agusoa2008-sudo/lsf-ecoypf-performance/motor y driver/driver.jpeg

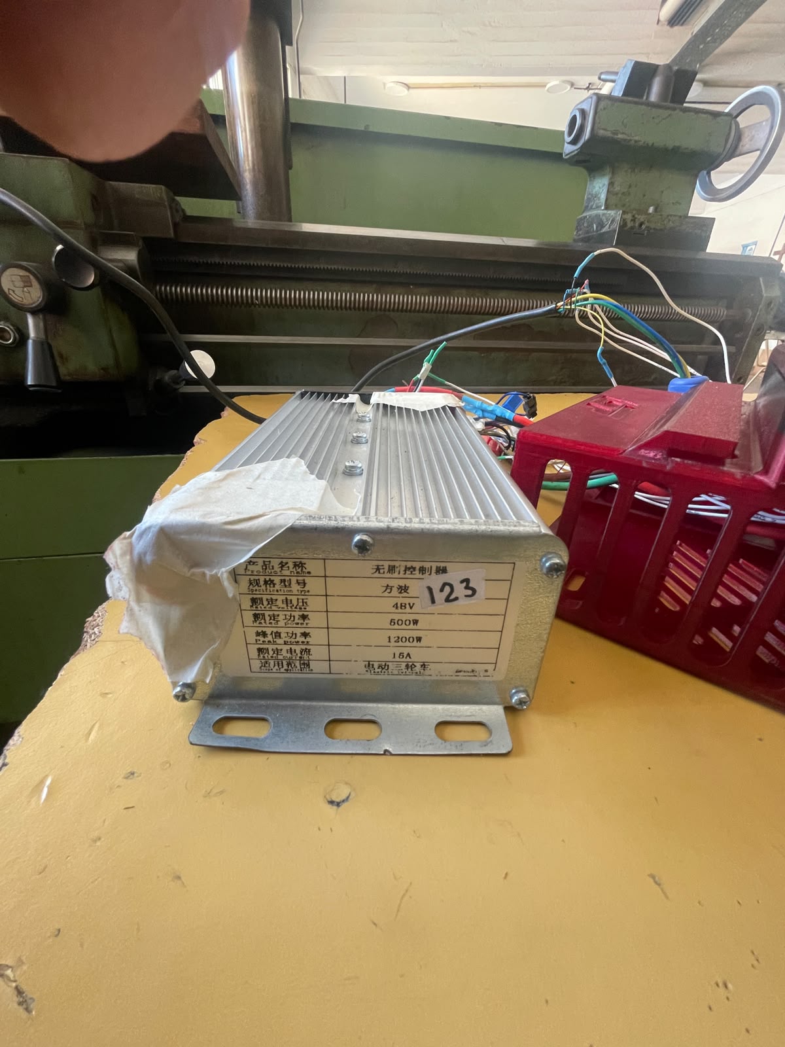
motor y driver/driver.jpeg
