agusoa2008-sudo/lsf-ecoypf-performance/motor y driver/motor.jpeg

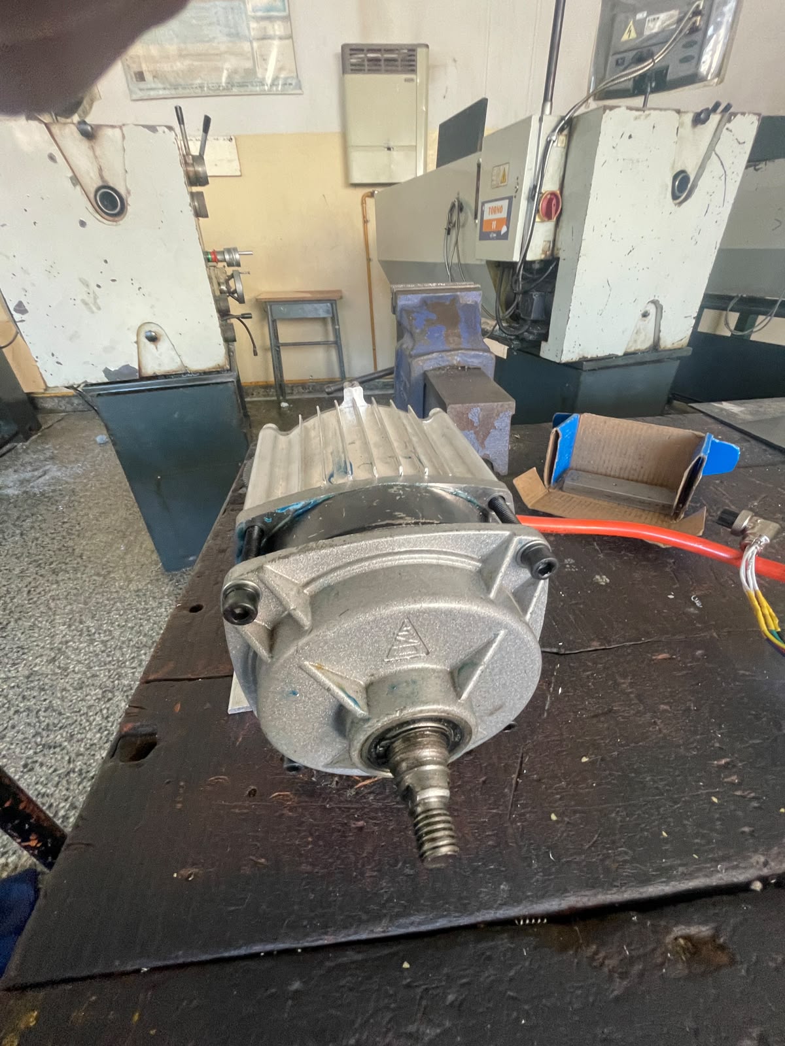
motor y driver/motor.jpeg
