agusoa2008-sudo/lsf-ecoypf-performance/Heltec T190/t190.pdf

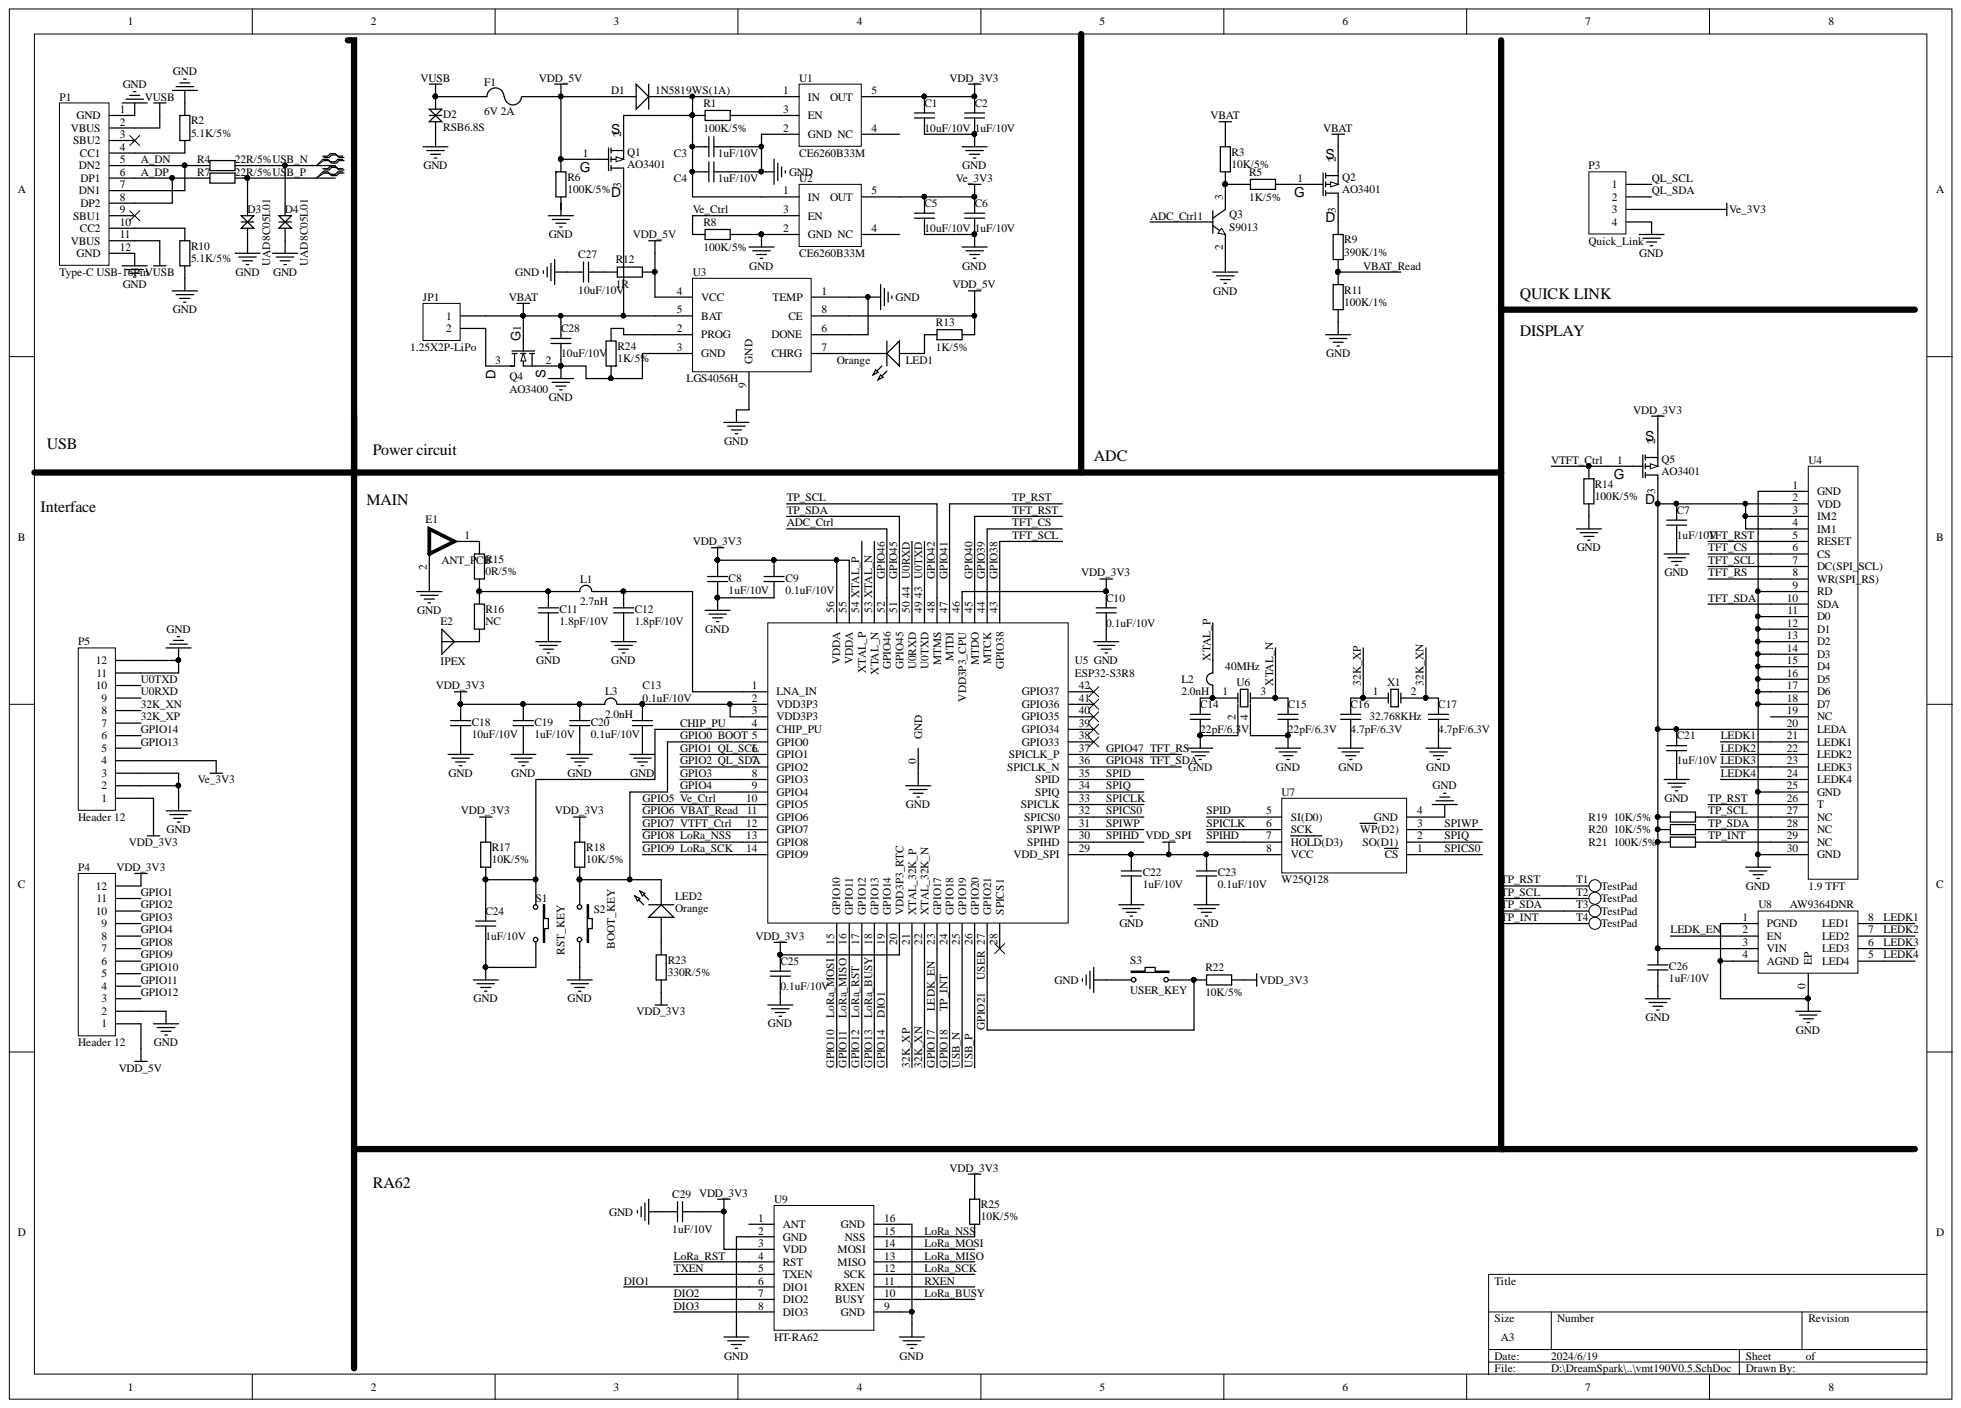
[picture p6: page 1]

GPIO38 43 MTCK 44 MTDO 45 VDD3P3_CPU 46 MTDI 47 MTMS 48 U0TXD 49 U0RXD 50 GPIO45 51 GPIO46 52 XTAL_N 53 XTAL_P 54 VDDA 55 VDDA 56 GND 0

3 | 12 MISO 13 MOSI 14 NSS 15 GND 16 1 SCK
