agusoa2008-sudo/lsf-ecoypf-performance/Heltec T190/sh2.0_interface_4F32C39EE011CAA34840C9E4E87704C4.pdf

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

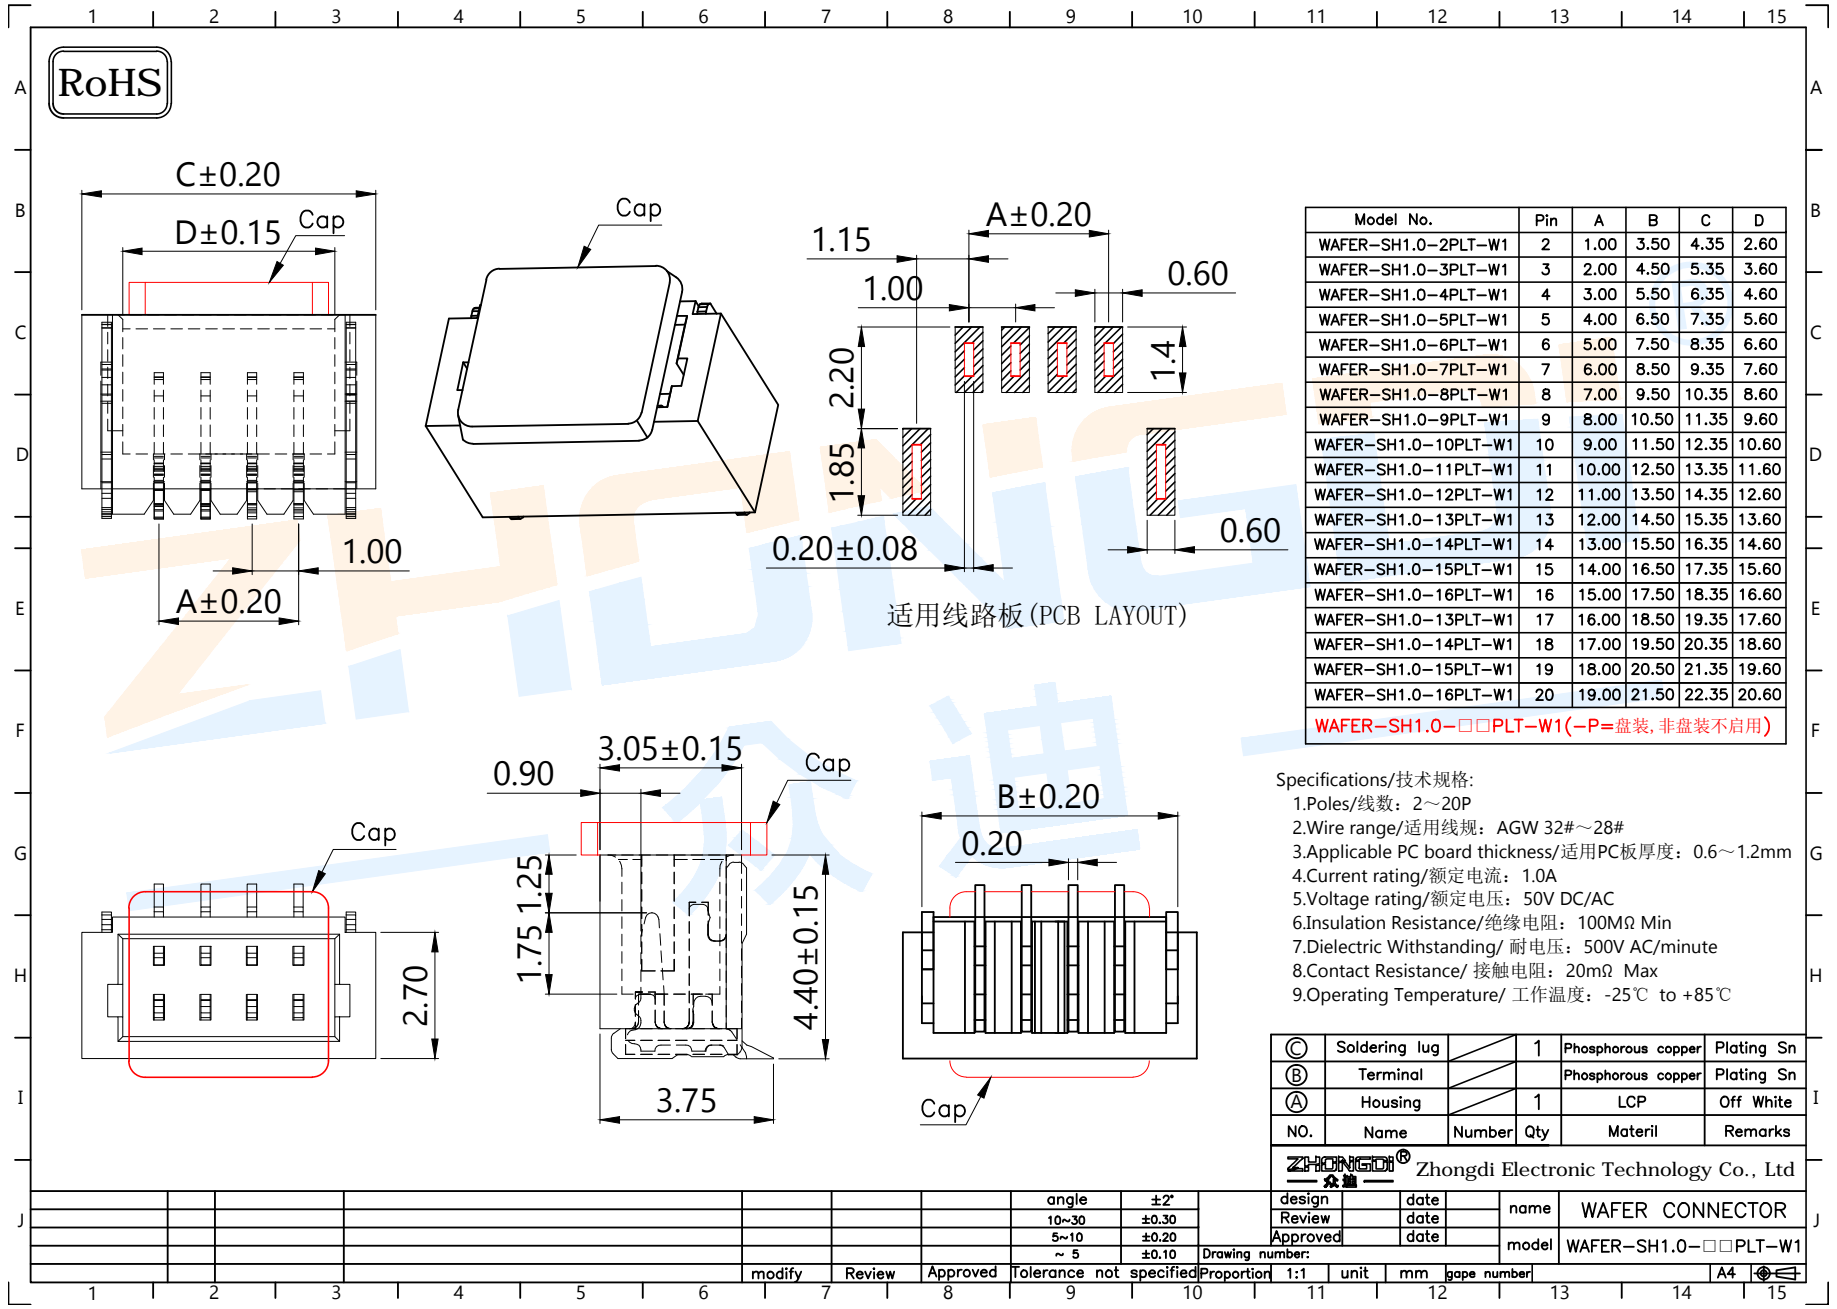
[picture p7: page 1]
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
