agusoa2008-sudo/lsf-ecoypf-performance/diagnostico espnow/t190-device/main.py

# main.py — Heltec T190 v3: display remoto del Super Mini (eBike2026)
#
# El T190 no lee los sensores de traccion/corriente/velocidad -- todo eso
# vive en el Super Mini (ver ../SUPER MINI S3/), que hace las lecturas y los
# calculos (Wh, potencia, eficiencia) y los manda por ESP-NOW. El T190
# solo recibe, muestra en pantalla, y reenvia por LoRa (SX1262) a una base
# remota. Tambien mide su bateria interna para mostrar el estado del T190.
# Ver espnow_link.py para el protocolo de pairing (T190 = quien
# acepta, Super Mini = iniciador -- INVERTIDO respecto a la version vieja
# de este archivo, que leia sensores locales y/o mandaba a un segundo
# display tipo Ideaspark).
#
# El Super Mini envia telemetria por ESP-NOW; el T190 la muestra y retransmite
# por LoRa. El GPS y la bateria local del T190 se supervisan en tareas propias.
#
# - Display: un valor a la vez, fuente 7 segmentos blanco sobre negro.
#   Fila de arriba: estado del link ESP-NOW (antes tenia hints de
#   navegacion prev/next, se saco para dejar lugar al estado).
#
# - Pantallas: PAGES (definida cerca del final del archivo) reemplaza la
#   vieja lista plana FIELDS -- cada pagina es un descriptor con su propia
#   funcion de dibujo. Pagina 0 = CARRERA (home, potencia objetivo vs.
#   actual). BTN0 corto ya no es contextual por pagina (ver mas abajo).
#
# - Dos botones (ver HW.py y ARQUITECTURA_TELEMETRIA_ECOYPF.md §5). Short
#   dispara siempre al instante al soltar; double es un evento ADICIONAL
#   (no exclusivo) que se suma si el segundo tap llega dentro de DOUBLE_MS
#   -- ver buttons.py. Combo: si se suelta un boton en modo "short" MIENTRAS
#   el otro esta sostenido, dispara el gesto "combo" de ese boton en vez de
#   short/double (ver buttons.py: PageButton._handle_release).
#     BTN0  (GPIO0)  corto          -> pantalla siguiente (bloqueado si hay
#                                     un modo especial activo, ver abajo)
#     BTN0  (GPIO0)  doble          -> ver ENERGIA restante 5s y volver solo
#                                     a la pantalla activa (_on_btn0_double_
#                                     peek_energia)
#     BTN0  (GPIO0)  largo          -> escape universal: siempre va a
#                                     CARRERA y sale de cualquier modo
#                                     especial activo (_on_home)
#     BTN0  (GPIO0)  extra (>=2.2s) -> activa el modo especial de la
#                                     pantalla actual (_on_btn0_extra)
#     BTN0 sostenido + S3 corto     -> reset remoto del Super Mini (combo,
#                                     con doble confirmacion -- ver Fase 5)
#     S3    (GPIO21) corto          -> pantalla anterior (mismo bloqueo)
#     S3    (GPIO21) doble          -> largada: captura waypoint GPS +
#                                     arranca el reloj de carrera (si no
#                                     estaba corriendo) + va al cartel de
#                                     CARRERA, sin entrar directo al modo
#                                     en vivo (_on_s3_double_start)
#     S3    (GPIO21) largo          -> ir a CONFIGURACION (solo navega;
#                                     no abre el AP, ver mas abajo)
#     S3    (GPIO21) extra (>=2.2s) -> deep sleep al soltar
#     S3 sostenido + BTN0 corto     -> alternar log SD (combo)
#
#   Modos especiales -- CARRERA, SPRINT, CONFIG, CARGA, REINICIO y
#   WAYPOINT son pantallas "cartel": en navegacion normal muestran solo
#   un aviso de entrada, nunca los datos en vivo. SIEMPRE hay que estar
#   parado en la pantalla correcta y sostener BTN0 extra (~2.2s) para
#   activar el modo -- no hay atajo que se salte este paso, ni siquiera
#   S3 doble. Mismo gesto para salir, excepto REINICIO y WAYPOINT, que
#   ejecutan al toque (no son un modo que se "entre"):
#     CARRERA  -> potencia actual vs. objetivo; arranca el reloj de 80 min
#     SPRINT   -> velocidad + cronometro propio de la tanda
#     CONFIG   -> abre/cierra el AP de configuracion (_on_config_ap_toggle)
#     CARGA    -> monitorea Wh+ mientras carga; al salir registra lo
#                 acumulado como la nueva capacidad del pack
#     REINICIO -> pone en cero viaje/reloj de carrera/Peukert sin tocar la
#                 capacidad registrada (_on_reinicio_execute)
#     WAYPOINT -> (re)captura el punto de largada/llegada GPS sin arrancar
#                 la carrera ni navegar a otro lado (_on_waypoint_execute)
#
#   _on_race_toggle (pausar/reanudar la carrera a mitad de tanda) quedo sin
#   gesto asignado -- a definir si hace falta (ver su docstring).
#
# Patron "REPL libre": toda la app corre en un _thread aparte (igual que
# uPy reference Martin/FC Upy/eBike Old/inDev/t.py). Al bootear, main.py
# arranca el hilo y retorna enseguida -- la consola queda disponible para
# llamar status() / stop() / start() / next_field() / prev_field() /
# reset_trip() / espnow_status() / espnow_repair() directo (sin
# `import main` -- ver nota en conversacion sobre por que).

import _thread
import sys
import math
import time
import machine
import esp32
import uasyncio as asyncio
from machine import Pin, SPI

import HW
from drivers.tft170 import TFT170, rgb565
from buttons import InterruptPageButton
from telemetry import TelemetryRuntime
from espnow_link import EspNowLink, mac_str
from battery import percent_from_voltage
from gps import GPSReceiver
from sd_logger import TripLogger
from settings import T190Settings, RACE_DURATION_S
from config_server import ConfigServer, AP_SSID, AP_IP
import seven_seg
from fonts import seven_segment_80 as SEG80
from fonts import seven_segment_40 as SEG40

try:
    from sx1262 import SX1262
except ImportError:
    SX1262 = None

BLACK = 0x0000
WHITE = 0xFFFF
GRAY = rgb565(220, 220, 220)
RED = rgb565(220, 40, 40)
GREEN = rgb565(40, 200, 40)

# ── Pantallas: ver PAGES, definida cerca del final de este archivo (luego
# de las funciones _draw_* y de los handlers de boton que referencia, ya
# que la lista se construye en orden de ejecucion del modulo). Reemplaza a
# la vieja lista plana FIELDS + los offsets fijos len(FIELDS)+N.

# Umbrales de cruce de vuelta por GPS (ver _check_lap_crossing) -- 15m de
# tolerancia alrededor del waypoint capturado con S3 corto, con cooldown
# para no contar como varias vueltas un paso lento por la linea.
LAP_CROSS_THRESHOLD_M = 15.0
LAP_COOLDOWN_MS = 20000

# Reset remoto del Super Mini (combo BTN0 sostenido + S3 corto, ver Fase 5):
# doble confirmacion (primer combo arma, hay que repetirlo dentro de esta
# ventana) + timeout de espera del ACK del Super Mini.
REMOTE_RESET_CONFIRM_WINDOW_MS = 5000
RESET_ACK_TIMEOUT_MS = 4000

AUTO_START = True
IDLE_SLEEP_TIMEOUT_MS = 20 * 60 * 1000
IDLE_SPEED_THRESHOLD_KMH = 0.1
IDLE_SLEEP_CHECK_INTERVAL_MS = 1000
# Si el Super Mini se duerme (o queda fuera de rango) deja de mandar ESP-NOW
# y la telemetria pasa a STALE (ver telemetry.SOURCE_STALE_MS). Pasado este
# tiempo adicional sin que vuelva, el T190 lo acompaña a deep sleep -- ya
# estaba recibiendo datos antes, no es el caso de "todavia no emparejo".
SUPERMINI_LOST_SLEEP_TIMEOUT_MS = 30 * 1000
SD_LOG_SAMPLE_INTERVAL_MS = 1000
_RUNNING = False
_STOP_REQUESTED = False
_SLEEP_REQUESTED = False
_LOG_MANUAL_OVERRIDE = None
_BG_THREAD_STACK = 12288

_rt = None          # TelemetryRuntime
_en = None          # EspNowLink
_lora = None
_shared_spi = None
_sd_logger = None
_sd_error = None
_tft = None
_field_idx = 0
_dirty = True
_battery_voltage = None
_battery_percent = None
_battery_error = None
_battery_adc_raw = None
_battery_adc_pin_voltage = None
_battery_adc_read_method = None
_gps = None
_lap_waypoint = None       # (lat, lon) de largada/llegada -- S3 doble o WAYPOINT
_lap_count = 0
_last_lap_time_s = None
_lap_start_ms = None
_lap_last_cross_ms = 0
_gps_clock_synced = False
_gps_time_update_seen = 0
_gps_last_rtc_sync_ms = 0
_settings = None
_CONFIG_AP_REQUESTED = False
_CONFIG_AP_STOP_REQUESTED = False
_CONFIG_AP_RUNNING = False
_supermini_config_ack_revision = None
_supermini_config_error = None
_supermini_config_error_revision = None
_charge_wh_accum = 0.0
_charge_session_active = False
_CHARGE_THRESHOLD_A = 0.5   # |I| magnitude to detect charge / discharge
_last_button_activity_ms = 0
_sleep_warn_s = None        # segundos restantes del auto-sleep en curso, o None
_sleep_warn_reason = None   # "idle" (parado) o "lost" (Super Mini ausente)
_toast_text = None          # confirmacion momentanea (waypoint, reset), o None
_toast_started_ms = 0
TOAST_DURATION_MS = 4000

_peek_page_idx = None        # indice de PAGES mostrado temporalmente, o None
_peek_until_ms = 0
PEEK_DURATION_MS = 5000      # BTN0 doble: cuanto se muestra ENERGIA antes de volver

# CARRERA (Endurance): banda verde alrededor de potencia objetivo -- afuera
# (de mas o de menos), rojo. 10W es punto de partida; si en banco titila
# demasiado con el ruido normal de PA (EMA de 5s), subir este numero.
CARRERA_POWER_TOLERANCE_W = 10

# Modo especial (CARRERA/SPRINT/CARGA): mismo patron para los tres --
# cartel de entrada en navegacion normal (_draw_*_launcher), BTN0
# extra-largo (~2.2s) parado ahi activa los valores en vivo (_LIVE_DRAW,
# ver _draw_field) y bloquea BTN0/S3 corto (_in_locked_mode) para no
# salirse sin querer; el mismo gesto de nuevo sale (_on_toggle_mode_lock).
# CONFIG/AP sigue el mismo gesto (BTN0 extra, ver _on_btn0_extra) pero
# con su propio estado async ya existente (_CONFIG_AP_RUNNING/
# _CONFIG_AP_REQUESTED) en vez de _mode_locked -- por eso ambos entran en
# _in_locked_mode(). REINICIO usa el mismo gesto pero es de una sola vez,
# sin modo que mantener (ver _on_reinicio_execute).
#
# Entrar arranca el cronometro/acumulador que corresponda: en CARRERA, el
# reloj de carrera de 80 min (si no estaba corriendo ya); en SPRINT, un
# cronometro local propio (a Sprint no le importa la energia, solo el
# tiempo); en CARGA, el acumulador de Wh+ arranca de 0. Salir de CARGA
# registra lo acumulado como la nueva capacidad del pack.
_mode_locked = False
_sprint_start_ms = None   # None = cronometro de SPRINT detenido


def _in_locked_mode():
    """True si hay algun modo especial activo (bloquea next/prev, ver
    _on_next/_on_prev) -- CARRERA/SPRINT/CARGA via _mode_locked, o
    CONFIG/AP via su propio estado async."""
    return _mode_locked or _CONFIG_AP_RUNNING or _CONFIG_AP_REQUESTED


def _sprint_elapsed_s():
    if _sprint_start_ms is None:
        return 0.0
    return time.ticks_diff(time.ticks_ms(), _sprint_start_ms) / 1000.0


# Reset remoto del Super Mini (ver _on_remote_reset_request/Fase 5)
_reset_request_id = 0
_reset_ack_status = None    # None|"pending"|"ok"|"rejected"|"failed"|"timeout"
_reset_ack_deadline_ms = 0
_remote_reset_armed_until_ms = 0


# ── Hardware ─────────────────────────────────────────────────────────────────

def make_display():
    HW.display_power_on()
    time.sleep_ms(20)
    spi = SPI(
        HW.TFT_SPI_ID, baudrate=HW.TFT_BAUDRATE, polarity=0, phase=0,
        sck=machine.Pin(HW.TFT_SCK), mosi=machine.Pin(HW.TFT_MOSI), miso=None,
    )
    return TFT170(
        spi,
        dc=machine.Pin(HW.TFT_DC, machine.Pin.OUT),
        rst=machine.Pin(HW.TFT_RST, machine.Pin.OUT),
        cs=machine.Pin(HW.TFT_CS, machine.Pin.OUT),
        bl=machine.Pin(HW.TFT_BL, machine.Pin.OUT),
        rotation=1,   # landscape 320x170 -- mas ancho para la fuente de 80px
    )


def make_shared_spi():
    try:
        Pin(HW.LORA_CS, Pin.OUT, value=1)
        Pin(HW.SD_CS_PIN, Pin.OUT, value=1)
        return SPI(
            HW.SD_SPI_ID, baudrate=2_000_000, polarity=0, phase=0,
            sck=Pin(HW.SD_SCK_PIN), mosi=Pin(HW.SD_MOSI_PIN),
            miso=Pin(HW.SD_MISO_PIN),
        )
    except Exception as exc:
        print("[SPI] no se pudo crear el bus compartido LoRa/SD:", exc)
        return None


def make_lora(spi=None):
    if SX1262 is None:
        print("[LoRa] driver sx1262 no disponible")
        return None
    try:
        lora = SX1262(
            spi_bus=2,  # distinto del SPI(1) del display (ver loralcd_test.py)
            clk=HW.LORA_SCK, mosi=HW.LORA_MOSI, miso=HW.LORA_MISO,
            cs=HW.LORA_CS, irq=HW.LORA_DIO1,
            rst=HW.LORA_RST, gpio=HW.LORA_BUSY, spi=spi,
        )
        lora.begin(
            freq=HW.LORA_FREQ_MHZ,
            bw=HW.LORA_BW_KHZ,
            sf=HW.LORA_SF,
            cr=HW.LORA_CR,
            syncWord=HW.LORA_SYNC_WORD,
            power=HW.LORA_POWER_DBM,
            currentLimit=HW.LORA_CURRENT_LIMIT_MA,
            preambleLength=HW.LORA_PREAMBLE_LEN,
            tcxoVoltage=HW.LORA_TCXO_VOLTAGE,
        )
        if spi is not None and lora.spi is not spi:
            raise RuntimeError("SX1262 no conserva la instancia SPI compartida")
        print("[LoRa] OK @ {} MHz BW={} SF{} CR4/{} {} dBm".format(
            HW.LORA_FREQ_MHZ, HW.LORA_BW_KHZ, HW.LORA_SF,
            HW.LORA_CR, HW.LORA_POWER_DBM))
        return lora
    except Exception as exc:
        print("[LoRa] init error:", exc)
        return None


def make_sd_logger(spi):
    global _sd_error
    if spi is None:
        _sd_error = "bus SPI no disponible"
        print("[SD] logger inactivo: no hay bus SPI compartido")
        return None
    logger = None
    try:
        logger = TripLogger(
            spi, sd_cs_pin=HW.SD_CS_PIN, lora_cs_pin=HW.LORA_CS,
            spi_baudrate=2_000_000,
        )
        logger.mount()
        if logger.card.spi is not spi:
            raise RuntimeError("driver SD no conserva la instancia SPI compartida")
    except Exception as exc:
        _sd_error = "{}".format(exc)
        if logger is not None:
            logger.error = _sd_error
        print("[SD] inicializacion fallida:", exc)
        return logger
    _sd_error = None
    print("[SD] FAT montado: {} sectores ({:.2f} GiB)".format(
        logger.sectors, logger.sectors * 512 / (1024 * 1024 * 1024)))
    return logger


def make_espnow(on_telemetry, on_config_ack, on_reset_ack):
    try:
        link = EspNowLink(
            on_telemetry=on_telemetry, on_config_ack=on_config_ack,
            on_reset_ack=on_reset_ack)
        if link.paired:
            print("[espnow] OK, peer recordado:", mac_str(link.peer))
        else:
            print("[espnow] OK, esperando Super Mini...")
        return link
    except Exception as exc:
        print("[espnow] init error:", exc)
        return None


def make_gps():
    try:
        uart = machine.UART(
            HW.GPS_UART_ID, baudrate=HW.GPS_BAUDRATE,
            tx=HW.GPS_TX_PIN, rx=HW.GPS_RX_PIN, timeout=0,
        )
        print("[GPS] UART{} RX=GPIO{} TX=GPIO{} @ {} baud".format(
            HW.GPS_UART_ID, HW.GPS_RX_PIN, HW.GPS_TX_PIN, HW.GPS_BAUDRATE))
        return GPSReceiver(uart)
    except Exception as exc:
        print("[GPS] init error:", exc)
        return None


# ── UI ───────────────────────────────────────────────────────────────────────

def _espnow_link_text():
    """Texto + color del estado del link ESP-NOW con el Super Mini, para
    la fila 1 (reemplaza los hints de navegacion prev/next de antes)."""
    if _en is None:
        return "ESPNOW: no disponible", RED
    if not _en.paired:
        return "ESPNOW: esperando Super Mini...", GRAY
    if _en.fresh and _rt is not None and _rt.source_fresh():
        age_s = time.ticks_diff(time.ticks_ms(), _en.last_rx_ms) / 1000.0
        return "ESPNOW: OK ({:.1f}s)".format(age_s), GREEN
    return "ESPNOW: SIN DATOS (perdido)", RED


def _gps_status():
    if _gps is None:
        return "GPS:ERR", RED
    sats = _gps.satellites
    if _gps.has_fix():
        return "GPS:{}s".format(sats), GREEN
    return "GPS:{}--".format(sats), GRAY


def _sd_log_status():
    if _sd_logger is None:
        return ("SD:ERR", RED) if _sd_error else ("SD:--", GRAY)
    if _sd_logger.error is not None:
        return "SD:ERR", RED
    if _sd_logger.recording:
        return "SD:REC", GREEN
    if _sd_logger.ready:
        return "SD:ARM", GRAY
    return "SD:--", GRAY


def _sleep_warning_text():
    """Texto de aviso de auto-sleep inminente (ver idle_sleep_task), o
    None si no hay ningun temporizador de auto-sleep corriendo."""
    if _sleep_warn_s is None:
        return None
    detail = "Super Mini ausente" if _sleep_warn_reason == "lost" else "detenido"
    return "DUERME EN {}s ({})".format(_sleep_warn_s, detail)


def _show_toast(text):
    """Confirmacion momentanea en pantalla (waypoint capturado, reset de
    viaje, etc.) -- ui_task redibuja cada <=300ms sin necesidad de
    _dirty, asi que alcanza con guardar el texto y el instante inicial
    para que _toast_line() lo apague solo pasado TOAST_DURATION_MS."""
    global _toast_text, _toast_started_ms, _dirty
    _toast_text = text
    _toast_started_ms = time.ticks_ms()
    _dirty = True


def _toast_line():
    if _toast_text is None:
        return None
    if time.ticks_diff(time.ticks_ms(), _toast_started_ms) >= TOAST_DURATION_MS:
        return None
    return _toast_text


def _trip_whkm_avg():
    """Wh/km del periodo actual (desde el ultimo reset_trip), calculado
    aca con los deltas locales de settings.py -- no es el WA de vida
    entera que manda el Super Mini, que no se entera de resets."""
    if _settings is None:
        return 0.0
    km = _settings.trip_distance_m / 1000.0
    return (_settings.battery_used_wh / km) if km > 0.01 else 0.0


def _art_timestamp():
    if not _gps_clock_synced:
        return None
    tm = time.localtime()
    return "{:04d}-{:02d}-{:02d} {:02d}:{:02d}:{:02d}".format(
        tm[0], tm[1], tm[2], tm[3], tm[4], tm[5])


def _format_mmss(seconds):
    seconds = max(0, int(seconds))
    return "{:02d}:{:02d}".format(seconds // 60, seconds % 60)


def _power_target_w():
    """Potencia objetivo (W) = energia restante (Peukert) / tiempo restante
    de carrera -- ver docs/ARQUITECTURA_TELEMETRIA_ECOYPF.md §0. None si la
    carrera no esta corriendo o todavia no hay linea de base de energia."""
    if _settings is None or _settings.race_state != "running":
        return None
    remaining_s = _settings.race_remaining_s()
    if remaining_s <= 0:
        return None
    energy_wh = _settings.energy_remaining_peukert_wh
    if energy_wh is None:
        return None
    return energy_wh / (remaining_s / 3600.0)


def _approx_distance_m(lat1, lon1, lat2, lon2):
    """Distancia aproximada (equirectangular) -- de sobra para las
    distancias cortas de una linea de largada/llegada de pista."""
    lat_rad = math.radians((lat1 + lat2) / 2.0)
    dlat_m = (lat2 - lat1) * 111320.0
    dlon_m = (lon2 - lon1) * 111320.0 * math.cos(lat_rad)
    return math.sqrt(dlat_m * dlat_m + dlon_m * dlon_m)


def _check_lap_crossing():
    """Si hay un waypoint de largada/llegada capturado (S3 corto) y el fix
    GPS actual esta a menos de LAP_CROSS_THRESHOLD_M, cuenta una vuelta --
    con cooldown para no contar varias veces un paso lento por la linea."""
    global _lap_count, _last_lap_time_s, _lap_start_ms, _lap_last_cross_ms
    global _dirty
    if _lap_waypoint is None or _gps is None:
        return
    fix = _gps.latest_fix()
    if fix is None:
        return
    now = time.ticks_ms()
    if time.ticks_diff(now, _lap_last_cross_ms) < LAP_COOLDOWN_MS:
        return
    distance_m = _approx_distance_m(
        _lap_waypoint[0], _lap_waypoint[1], fix["latitude"], fix["longitude"])
    if distance_m > LAP_CROSS_THRESHOLD_M:
        return
    _lap_count += 1
    if _lap_start_ms is not None:
        _last_lap_time_s = time.ticks_diff(now, _lap_start_ms) / 1000.0
    _lap_start_ms = now
    _lap_last_cross_ms = now
    _show_toast("Vuelta {} -- {}".format(
        _lap_count, _format_mmss(_last_lap_time_s or 0)))
    _dirty = True


def _page_count():
    return len(PAGES)


def _page_label(idx):
    return PAGES[idx]["label"]


def _draw_diagnostics(tft, idx):
    tft.fill(BLACK)
    tft.text("DIAGNOSTICO  {}/{}".format(idx + 1, _page_count()), 8, 4, WHITE)
    tft.hline(0, 20, tft.width, rgb565(70, 80, 90))

    state = _rt.state if _rt is not None else None
    source_fresh = _rt is not None and _rt.source_fresh()
    if state is None or not source_fresh:
        ads_text, ads_color = "ADS: sin telemetria fresca", RED
    else:
        ads_text = "ADS V:{}  I:{}  RX:{}#{}".format(
            "OK" if state.adc_valid else "ERR",
            "OK" if state.current_valid else "ERR",
            state.espnow_rx_count, state.source_seq)
        ads_color = GREEN if state.adc_valid and state.current_valid else RED
    tft.text(ads_text[:39], 8, 30, ads_color)

    if _sd_logger is None:
        sd_detail = _sd_error or "no inicializada"
        sd_color = RED if _sd_error else GRAY
    elif _sd_logger.error:
        sd_detail = _sd_logger.error
        sd_color = RED
    elif _sd_logger.recording:
        sd_detail = "REC {}".format(_sd_logger.path)
        sd_color = GREEN
    elif _sd_logger.ready:
        sd_detail = "OK {:.1f} GiB".format(
            _sd_logger.sectors * 512 / (1024 * 1024 * 1024))
        sd_color = WHITE
    else:
        sd_detail = "no montada"
        sd_color = RED
    tft.text(("SD: " + sd_detail)[:39], 8, 48, sd_color)

    if _gps is None:
        gps_text, gps_color = "GPS: no inicializado", RED
    elif _gps.has_fix():
        gps_text = "GPS FIX sats:{}".format(_gps.satellites)
        gps_color = GREEN
    else:
        gps_text = "GPS sin fix sats:{}".format(_gps.satellites)
        gps_color = GRAY
    tft.text(gps_text[:39], 8, 66, gps_color)

    timestamp = _art_timestamp()
    clock_text = "ART: {}".format(timestamp) if timestamp else "ART: esperando hora GPS"
    tft.text(clock_text[:39], 8, 84, WHITE if timestamp else GRAY)

    if _settings is not None:
        race_text = "CARRERA {} T:{} R:{}".format(
            _settings.race_state.upper(),
            _format_mmss(_settings.race_elapsed_s()),
            _format_mmss(_settings.race_remaining_s()))
        race_color = GREEN if _settings.race_state == "running" else GRAY
    else:
        race_text, race_color = "CARRERA: sin datos", GRAY
    tft.text(race_text[:39], 8, 102, race_color)

    if _battery_voltage is None:
        battery_text, battery_color = "T190 BAT: lectura no valida", RED
    else:
        battery_text = "T190 {:.2f}V  {}%  ADC:{}".format(
            _battery_voltage, _battery_percent, _battery_adc_raw)
        battery_color = GREEN
    tft.text(battery_text[:39], 8, 120, battery_color)

    if _settings is not None and _settings.battery_percent is not None:
        peukert_rem = _settings.energy_remaining_peukert_wh
        pack_text = "PACK {}%  lin:{:.0f} peuk:{:.0f}Wh".format(
            _settings.battery_percent, _settings.battery_remaining_wh,
            peukert_rem if peukert_rem is not None else 0.0)
        pack_color = GREEN
    elif _settings is not None and _settings.battery_capacity_wh > 0:
        pack_text, pack_color = "PACK: marca carga completa", GRAY
    else:
        pack_text, pack_color = "PACK: capacidad sin configurar", GRAY
    tft.text(pack_text[:39], 8, 138, pack_color)
    tft.show()


def _draw_configuration(tft, idx):
    tft.fill(BLACK)
    tft.text("CONFIGURACION  {}/{}".format(idx + 1, _page_count()), 8, 4, WHITE)
    tft.hline(0, 22, tft.width, rgb565(70, 80, 90))
    tft.text("AJUSTES DESDE EL TELEFONO", 8, 37, WHITE)
    if _CONFIG_AP_RUNNING:
        tft.text("BTN0 ~2s: cerrar AP", 8, 62, WHITE)
        tft.text("BTN0 largo: cancelar y salir", 8, 83, WHITE)
        tft.text("SSID: {}".format(AP_SSID), 8, 105, GREEN)
        tft.text("http://{}/".format(AP_IP), 8, 127, GREEN)
        tft.text("WPA2: lasalle2026", 8, 149, WHITE)
    else:
        tft.text("BTN0 ~2s: iniciar AP", 8, 62, WHITE)
        tft.text("S3 corto: pantalla anterior", 8, 83, WHITE)
        tft.text("S3 largo: venir aqui", 8, 105, GRAY)
        if _settings is not None:
            factors = _settings.b_supermini_factors_milli
            tft.text("Factores B1..4: {} {} {} {}".format(
                factors[0], factors[1], factors[2], factors[3]),
                8, 127, WHITE)
            if _settings.battery_capacity_wh > 0:
                tft.text("Pack {:.0f} Wh".format(
                    _settings.battery_capacity_wh), 8, 149, WHITE)
    tft.show()


def _draw_carga_launcher(tft, idx):
    """Pagina CARGA en navegacion normal: cartel de entrada, mismo patron
    que CARRERA/SPRINT -- el monitor en vivo (_draw_carga_live) se activa
    sosteniendo BTN0 ~2.2s desde aca."""
    tft.fill(BLACK)
    _draw_status_row(tft)
    tft.text("CARGA  {}/{}".format(idx + 1, _page_count()), 8, 20, WHITE)
    tft.hline(0, 34, tft.width, rgb565(70, 80, 90))
    seven_seg.draw_text_centered(tft, SEG40, "CARGA", 46, WHITE)
    tft.text("Mantene BTN0 ~2s para entrar", 8, 100, GRAY)
    if _settings is not None:
        tft.text("Capacidad actual: {:.0f} Wh".format(
            _settings.battery_capacity_wh), 8, 116, GRAY)
    _draw_footer_row(tft, idx)
    tft.show()


def _draw_carga_live(tft, idx):
    """Modo carga activo (ver _draw_carga_launcher): monitorea corriente
    y acumula Wh+ en tiempo real (charge_task). Al entrar se reinicia el
    acumulador a 0 (_on_charge_session_reset, sesion nueva); al salir
    (mismo gesto) lo acumulado se registra como la nueva capacidad del
    pack (_on_toggle_mode_lock -> T190Settings.set_battery_capacity_from_
    charge) -- no hace falta anotar el numero a mano ni pasar por el AP."""
    tft.fill(BLACK)
    tft.text("CARGA  {}/{}".format(idx + 1, _page_count()), 8, 4, WHITE)
    tft.hline(0, 17, tft.width, rgb565(70, 80, 90))

    state = _rt.state if _rt is not None else None
    fresh = _rt is not None and _rt.source_fresh()
    if state is None or not fresh:
        tft.text("Sin telemetria fresca del Super Mini", 8, 30, RED)
        tft.show()
        return

    i = state.i_bat
    if i < -_CHARGE_THRESHOLD_A:
        dir_text, dir_color = "CARGANDO   +", GREEN
    elif i > _CHARGE_THRESHOLD_A:
        dir_text, dir_color = "DESCARGANDO  -", RED
    else:
        dir_text, dir_color = "REPOSO", GRAY

    tft.text(dir_text, 8, 22, dir_color)

    i_str = "{:.2f}".format(abs(i))
    a_w = seven_seg.text_width(SEG40, "A")
    i_w = seven_seg.text_width(SEG40, i_str)
    free_w = tft.width - 16 - a_w - 8
    i_x = 8 + (free_w - i_w) // 2
    seven_seg.draw_text(tft, SEG40, i_str, i_x, 34, dir_color, BLACK)
    seven_seg.draw_text(tft, SEG40, "A", tft.width - a_w - 8, 34, WHITE, BLACK)

    tft.text("B1:{:.2f}V  B2:{:.2f}V".format(state.v_b1, state.v_b2), 8, 82, WHITE)
    tft.text("B3:{:.2f}V  B4:{:.2f}V".format(state.v_b3, state.v_b4), 8, 94, WHITE)
    tft.text("VBATS: {:.2f}V".format(state.v_bats), 8, 106, WHITE)

    tft.hline(0, 118, tft.width, rgb565(50, 50, 50))

    tft.text("Wh+ sesion: {:.1f}".format(_charge_wh_accum), 8, 126,
              GREEN if _charge_session_active else GRAY)
    tft.text("BTN0 ~2s: registrar y salir", 8, 138, GRAY)
    tft.show()


def _draw_reinicio(tft, idx):
    """Pagina REINICIO: pone en cero todo lo temporal de la tanda --
    distancia, Wh consumidos, reloj de carrera, acumulador Peukert --
    sin tocar la capacidad del pack registrada en modo CARGA ni las
    calibraciones (ver _on_reinicio_execute/_on_btn0_extra_reset). A
    diferencia de CARRERA/SPRINT/CARGA, aca no hay un modo que mantener
    ni del que salir: BTN0 ~2.2s ejecuta el reset una sola vez, al toque."""
    tft.fill(BLACK)
    _draw_status_row(tft)
    tft.text("REINICIO  {}/{}".format(idx + 1, _page_count()), 8, 20, WHITE)
    tft.hline(0, 34, tft.width, rgb565(70, 80, 90))
    dist = _settings.trip_distance_m if _settings is not None else 0.0
    wh = _settings.battery_used_wh if _settings is not None else 0.0
    cap = _settings.battery_capacity_wh if _settings is not None else 0.0
    tft.text("Borra: dist {:.0f}m, Wh {:.1f}".format(dist, wh)[:39], 8, 46, WHITE)
    tft.text("Borra: reloj de carrera y Peukert", 8, 62, WHITE)
    tft.text("NO toca capacidad: {:.0f} Wh".format(cap), 8, 82, GREEN)
    tft.text("Mantene BTN0 ~2s para reiniciar", 8, 102, GRAY)
    _draw_footer_row(tft, idx)
    tft.show()


def _draw_grabar(tft, idx):
    """Pantalla GRABAR: estado del log SD + arrancar/detener la grabacion
    manteniendo BTN0 ~2.2s (ver _on_btn0_extra -> _on_log_record_toggle).
    El control de grabacion vive aca, en el T190, NO en la web (pedido del
    equipo): recien con el log DETENIDO el AP deja descargar/borrar."""
    tft.fill(BLACK)
    _draw_status_row(tft)
    tft.text("GRABAR  {}/{}".format(idx + 1, _page_count()), 8, 20, WHITE)
    tft.hline(0, 34, tft.width, rgb565(70, 80, 90))
    if _sd_logger is None or not _sd_logger.ready:
        detail = _sd_error if _sd_logger is None else _sd_logger.error
        seven_seg.draw_text_centered(tft, SEG40, "SIN SD", 46, RED)
        tft.text(("microSD: {}".format(detail or "no disponible"))[:39],
                 8, 100, GRAY)
    elif _sd_logger.recording:
        seven_seg.draw_text_centered(tft, SEG40, "GRABANDO", 46, RED)
        tft.text(("Archivo: {}".format(_sd_logger.path or "-"))[:39],
                 8, 92, WHITE)
        tft.text("Mantene BTN0 ~2s para DETENER", 8, 108, GRAY)
    else:
        seven_seg.draw_text_centered(tft, SEG40, "DETENIDO", 46, GREEN)
        tft.text("Log detenido: ya podes descargar", 8, 92, WHITE)
        tft.text("Mantene BTN0 ~2s para GRABAR", 8, 108, GRAY)
    _draw_footer_row(tft, idx)
    tft.show()


def _draw_help(tft, idx):
    C = 160   # column separator x
    G = rgb565(70, 80, 90)
    D = rgb565(50, 50, 50)
    tft.fill(BLACK)
    tft.text("AYUDA BOTONES  {}/{}".format(idx + 1, _page_count()), 8, 4, WHITE)
    tft.hline(0, 17, tft.width, G)

    # Column headers
    tft.text("BTN0 / GPIO0", 4, 22, GREEN)
    tft.text("S3 / GPIO21", C + 4, 22, GREEN)
    tft.hline(0, 33, tft.width, D)
    tft.vline(C, 17, 71, D)

    # Gesture rows  — label x=4/C+4, action x=52/C+52
    LBL = 4
    ACT = 52
    def row(y, gesture, left_action, right_action):
        tft.text(gesture, LBL, y, GRAY)
        tft.text(left_action,  ACT,      y, WHITE)
        tft.text(gesture, C + LBL, y, GRAY)
        tft.text(right_action, C + ACT,  y, WHITE)

    row(40, "corto", "siguiente*", "anterior*")
    row(52, "doble", "energia 5s", "largada")
    row(64, "largo", "ir CARRERA**", "ir CONFIG")
    row(76, "extra", "activar***", "deep sleep")

    tft.hline(0, 88, tft.width, D)

    # Footer hints
    tft.text("*bloqueado si hay un modo activo"[:39], 4, 92, GRAY)
    tft.text("**universal: sale de cualquier modo"[:39], 4, 104, GRAY)
    tft.text("***CARRERA/SPRINT/CARGA/CONFIG (toggle)"[:39], 4, 116, GRAY)
    tft.text("REINICIO/WAYPOINT: *** al toque, sin modo"[:39], 4, 128, GRAY)
    tft.text("Combo S3 sost.+BTN0 corto: log SD"[:39], 4, 140, GRAY)
    tft.text("Combo BTN0 sost.+S3 corto: reset SM (<5s)"[:39], 4, 152, GRAY)
    tft.show()


def _draw_battery(tft):
    if _battery_percent is None:
        color = GRAY
        label = "--%"
        fill_width = 0
    else:
        label = "{}%".format(_battery_percent)
        color = GREEN if _battery_percent > 25 else RED
        fill_width = 18 * _battery_percent // 100
    tft.rect(258, 2, 22, 12, color)
    tft.fill_rect(282, 5, 2, 6, color)
    if fill_width:
        tft.fill_rect(260, 4, fill_width, 8, color)
    tft.text(label, 287, 4, color)


def _draw_status_row(tft):
    """Fila 1, comun a todas las paginas de valor: estado del link
    ESP-NOW con el Super Mini, SD, GPS y bateria del T190."""
    link_text, link_color = _espnow_link_text()
    tft.text(link_text[:19], 2, 4, link_color)
    log_text, log_color = _sd_log_status()
    tft.text(log_text, 158, 4, log_color)
    gps_text, gps_color = _gps_status()
    tft.text(gps_text, 210, 4, gps_color)
    _draw_battery(tft)


def _draw_footer_row(tft, idx):
    """Fila 3, comun a todas las paginas de valor: estado LoRa/fuente,
    indice de pagina, y avisos (sleep inminente / toast)."""
    st = _rt.state
    tft.hline(0, 120, tft.width, rgb565(50, 50, 50))
    src = "SRC:OK" if _rt.source_fresh() else "SRC:STALE"
    validity = "V{}I{}".format(
        int(st.adc_valid and _rt.source_fresh()),
        int(st.current_valid and _rt.source_fresh()))
    gps_state = "GPS:OK" if _gps is not None and _gps.has_fix() else "GPS:--"
    status = "TX:{}#{} {} {} {} RX:{}".format(
        "OK" if st.lora_ok else "--", st.lora_tx_count, src, validity,
        gps_state, st.espnow_rx_count,
    )
    tft.text(status[:32], 2, 128, WHITE)
    tft.text("{}/{}".format(idx + 1, _page_count()), tft.width - 42, 128,
              GREEN if (_en is not None and _en.fresh) else RED)

    warn_text = _sleep_warning_text()
    if warn_text is not None:
        tft.text(warn_text[:38], 2, 144, RED)
    else:
        toast_text = _toast_line()
        if toast_text is not None:
            tft.text(toast_text[:38], 2, 144, GREEN)


def _draw_big_value_page(tft, idx, group, label, code, unit, fmt, getter,
                          secondary=None):
    """Layout landscape 320x170 (rotation=1) comun a la mayoria de las
    paginas: fila de estado, cifra grande (codigo font40 + valor font80 +
    unidad font40) con su label debajo, y fila de pie. Reemplaza al viejo
    _draw_field generico que leia de FIELDS[idx] -- ahora cada pagina pasa
    sus propios group/label/code/unit/fmt/getter."""
    st = _rt.state
    fresh = _rt.source_fresh()
    value_str = fmt.format(getter(st)) if fresh else "--"
    value_color = WHITE if fresh else GRAY

    tft.fill(BLACK)
    _draw_status_row(tft)

    # El valor se centra en el hueco libre entre codigo y unidad (no en el
    # ancho total): "Wh/km"/"km/h" de unidad o 5 digitos de distancia
    # pueden ser mas anchos que el margen fijo y pisar al valor centrado
    # a lo bestia contra el ancho completo.
    code_w = seven_seg.text_width(SEG40, code)
    unit_w = seven_seg.text_width(SEG40, unit)
    value_w = seven_seg.text_width(SEG80, value_str)
    gap = 8
    left_bound = 8 + code_w + gap
    right_bound = tft.width - 8 - unit_w - gap
    free_w = right_bound - left_bound
    value_x = left_bound + (free_w - value_w) // 2

    seven_seg.draw_text(tft, SEG40, code, 8, 60, WHITE, BLACK)
    seven_seg.draw_text(tft, SEG80, value_str, value_x, 24, value_color, BLACK)
    seven_seg.draw_text(tft, SEG40, unit, tft.width - unit_w - 8, 60, WHITE, BLACK)
    tft.text("{} / {}".format(group, label), 8, 104, WHITE)
    if secondary is not None:
        sec_label, sec_fmt, sec_getter = secondary
        sec_val = sec_fmt.format(sec_getter(st))
        sec_text = ("{}: {}".format(sec_label, sec_val) if sec_label
                    else sec_val)
        tft.text(sec_text[:36], 8, 112, GRAY)

    _draw_footer_row(tft, idx)
    tft.show()


def _draw_carrera_launcher(tft, idx):
    """Pagina CARRERA en navegacion normal: solo un cartel de entrada --
    el modo Endurance en vivo (_draw_carrera_live) se activa unicamente
    sosteniendo BTN0 ~2.2s desde aca (_on_btn0_extra), igual que el AP en
    CONFIGURACION (_draw_configuration): primero hay que estar parado en
    la pagina correcta, despues sostener. No hay atajo que se salte este
    paso -- ni siquiera S3 doble (_on_s3_double_start) entra directo al
    modo en vivo, solo te deja parado aca con la carrera ya arrancada."""
    tft.fill(BLACK)
    _draw_status_row(tft)
    tft.text("CARRERA  {}/{}".format(idx + 1, _page_count()), 8, 20, WHITE)
    tft.hline(0, 34, tft.width, rgb565(70, 80, 90))
    seven_seg.draw_text_centered(tft, SEG40, "ENDURANCE", 46, WHITE)
    tft.text("Mantene BTN0 ~2s para entrar", 8, 100, GRAY)
    _draw_footer_row(tft, idx)
    tft.show()


def _draw_sprint_launcher(tft, idx):
    """Pagina SPRINT en navegacion normal: mismo patron de cartel que
    _draw_carrera_launcher -- el modo en vivo (_draw_sprint_live) se
    activa sosteniendo BTN0 ~2.2s desde aca."""
    tft.fill(BLACK)
    _draw_status_row(tft)
    tft.text("SPRINT  {}/{}".format(idx + 1, _page_count()), 8, 20, WHITE)
    tft.hline(0, 34, tft.width, rgb565(70, 80, 90))
    seven_seg.draw_text_centered(tft, SEG40, "SPRINT", 46, WHITE)
    tft.text("Mantene BTN0 ~2s para entrar", 8, 100, GRAY)
    _draw_footer_row(tft, idx)
    tft.show()


def _draw_carrera_live(tft, idx):
    """Modo Endurance activo (ver _draw_carrera_launcher para como se
    entra): potencia actual (izquierda) vs. potencia objetivo (derecha),
    lado a lado para comparar de un vistazo -- el dato central del
    proyecto, ver docs/ARQUITECTURA_TELEMETRIA_ECOYPF.md §0."""
    st = _rt.state
    pa = st.p_avg5s
    target = _power_target_w()
    actual_str = "{:.0f}".format(pa)
    target_str = "{:.0f}".format(target) if target is not None else "--"
    in_band = target is not None and abs(pa - target) <= CARRERA_POWER_TOLERANCE_W
    actual_color = GRAY if target is None else (GREEN if in_band else RED)
    target_color = GRAY if target is None else WHITE

    tft.fill(BLACK)
    _draw_status_row(tft)

    half = tft.width // 2
    col_top, col_bottom = 20, 94
    tft.vline(half, col_top, col_bottom - col_top, rgb565(70, 80, 90))
    tft.text("ACTUAL", 8, col_top + 4, WHITE)
    tft.text("OBJETIVO", half + 8, col_top + 4, WHITE)

    seven_seg.draw_text_centered(tft, SEG40, actual_str, 46, actual_color,
                                  width=half, x0=0)
    seven_seg.draw_text_centered(tft, SEG40, target_str, 46, target_color,
                                  width=tft.width - half, x0=half)
    tft.text("CARRERA / ENDURANCE (W)", 8, 104, WHITE)

    state_label = {
        "idle": "LISTO", "running": "EN CARRERA",
        "paused": "PAUSA", "finished": "FINALIZADA",
    }.get(_settings.race_state if _settings is not None else "idle", "LISTO")
    elapsed = _settings.race_elapsed_s() if _settings is not None else 0.0
    remaining = (_settings.race_remaining_s() if _settings is not None
                 else RACE_DURATION_S)
    tft.text("{} T:{} R:{} PA:{:.0f}W".format(
        state_label, _format_mmss(elapsed), _format_mmss(remaining), pa
    )[:36], 8, 112, GRAY)

    _draw_footer_row(tft, idx)
    tft.show()


def _draw_sprint_live(tft, idx):
    """Modo sprint activo (ver _draw_sprint_launcher para como se entra):
    sin presupuesto de energia que administrar, un solo numero grande --
    velocidad actual -- con el cronometro propio de la tanda abajo chico
    (_sprint_elapsed_s, arranca solo al entrar, ver _on_toggle_mode_lock).
    A diferencia de CARRERA (Endurance), aca no hay nada contra que
    comparar la velocidad; el tiempo es solo referencia del piloto."""
    _draw_big_value_page(
        tft, idx, "SPRINT", "VELOCIDAD", "SPD", "km/h", "{:.0f}",
        lambda s: s.speed_kmh,
        secondary=("T", "{}", lambda s: _format_mmss(_sprint_elapsed_s())))


def _draw_ruta(tft, idx):
    _draw_big_value_page(
        tft, idx, "RUTA", "VELOCIDAD", "SPD", "km/h", "{:.1f}",
        lambda s: s.speed_kmh,
        secondary=("", "{}", lambda s: "Wh/km:{:.1f}  SAT:{}".format(
            _trip_whkm_avg(), _gps.satellites if _gps is not None else "--")))


def _draw_consumo(tft, idx):
    _draw_big_value_page(
        tft, idx, "CONSUMO", "POT INSTANT", "PI", "W", "{:.0f}",
        lambda s: s.p_inst,
        secondary=("I", "{:.2f}A", lambda s: s.i_bat))


def _draw_eficiencia(tft, idx):
    _draw_big_value_page(
        tft, idx, "EFICIENCIA", "Wh/km PROM", "WA", "Wh/km", "{:.1f}",
        lambda s: _trip_whkm_avg(),
        secondary=("WI", "{:.1f}", lambda s: s.whkm_inst))


def _draw_viaje(tft, idx):
    _draw_big_value_page(
        tft, idx, "VIAJE", "DISTANCIA", "DST", "m", "{:.0f}",
        lambda s: _settings.trip_distance_m if _settings else 0.0,
        secondary=("Pot.prom 5s", "{:.0f}W", lambda s: s.p_avg5s))


def _draw_pulsos(tft, idx):
    """Pantalla CALIBRACION/PULSOS, recreada igual que antes del PR (ver
    FIELDS viejo): contador crudo de pulsos de rueda tal como llega del
    Super Mini (campo PC), sin convertir a distancia. Sirve para calibrar
    meters_per_pulse rodando una distancia conocida y dividiendo metros
    recorridos por el delta de pulsos."""
    _draw_big_value_page(
        tft, idx, "CALIBRACION", "PULSOS", "PLS", "", "{}",
        lambda s: s.pulse_count)


def _draw_baterias(tft, idx):
    tft.fill(BLACK)
    _draw_status_row(tft)
    tft.text("BATERIAS  {}/{}".format(idx + 1, _page_count()), 8, 20, WHITE)
    tft.hline(0, 34, tft.width, rgb565(70, 80, 90))
    st = _rt.state
    if not _rt.source_fresh():
        tft.text("Sin telemetria fresca", 8, 50, RED)
    else:
        tft.text("B1: {:.2f} V".format(st.v_b1), 8, 42, WHITE)
        tft.text("B2: {:.2f} V".format(st.v_b2), 8, 58, WHITE)
        tft.text("B3: {:.2f} V".format(st.v_b3), 8, 74, WHITE)
        tft.text("B4: {:.2f} V".format(st.v_b4), 8, 90, WHITE)
        tft.text("VBATS TOTAL: {:.2f} V".format(st.v_bats), 8, 106, GREEN)
    _draw_footer_row(tft, idx)
    tft.show()


def _draw_energia(tft, idx):
    tft.fill(BLACK)
    _draw_status_row(tft)
    tft.text("ENERGIA  {}/{}".format(idx + 1, _page_count()), 8, 20, WHITE)
    tft.hline(0, 34, tft.width, rgb565(70, 80, 90))
    if _settings is None:
        tft.text("Sin datos", 8, 50, RED)
    else:
        peukert_rem = _settings.energy_remaining_peukert_wh
        linear_rem = _settings.battery_remaining_wh
        percent = _settings.battery_percent
        rem_text = "{:.0f} Wh".format(peukert_rem) if peukert_rem is not None else "--"
        tft.text("RESTANTE: {}".format(rem_text), 8, 42,
                  GREEN if peukert_rem is not None else GRAY)
        tft.text("Usados: {:.0f} Wh".format(_settings.battery_used_wh), 8, 62, WHITE)
        lin_text = "{:.0f} Wh".format(linear_rem) if linear_rem is not None else "--"
        tft.text("Lineal: {}  PACK: {}%".format(
            lin_text, percent if percent is not None else "--"), 8, 82, GRAY)
    _draw_footer_row(tft, idx)
    tft.show()


def _draw_gps(tft, idx):
    tft.fill(BLACK)
    _draw_status_row(tft)
    tft.text("GPS  {}/{}".format(idx + 1, _page_count()), 8, 20, WHITE)
    tft.hline(0, 34, tft.width, rgb565(70, 80, 90))
    if _gps is None:
        tft.text("GPS no disponible", 8, 50, RED)
    else:
        fix = _gps.latest_fix()
        if fix is None:
            tft.text("Sin fix. Sats: {}".format(_gps.satellites), 8, 42, GRAY)
        else:
            tft.text("Fix: {:.5f}, {:.5f}".format(
                fix["latitude"], fix["longitude"]), 8, 42, GREEN)
            tft.text("Sats: {}".format(fix["satellites"]), 8, 58, WHITE)
        if _lap_waypoint is None:
            tft.text("Waypoint: no capturado (ver WAYPOINT)", 8, 74, GRAY)
        else:
            tft.text("Waypoint: {:.5f}, {:.5f}".format(*_lap_waypoint), 8, 74, WHITE)
        lap_text = "VUELTAS: {}".format(_lap_count)
        if _last_lap_time_s is not None:
            lap_text += "  ULTIMA: {}".format(_format_mmss(_last_lap_time_s))
        tft.text(lap_text, 8, 90, GREEN if _lap_count else GRAY)
    _draw_footer_row(tft, idx)
    tft.show()


def _draw_waypoint(tft, idx):
    """Pagina WAYPOINT: (re)captura el punto de largada/llegada para el
    conteo de vueltas por GPS, independiente de arrancar la carrera.
    Antes la unica forma de setearlo era S3 doble (_on_s3_double_start),
    que ademas arranca el reloj de Endurance y navega al cartel de
    CARRERA -- esta pagina sirve para recalibrar el punto sin tocar nada
    de eso. Igual que REINICIO: un solo gesto, sin modo que mantener ni
    del que salir -- BTN0 ~2.2s ejecuta la captura al toque (ver
    _on_waypoint_execute)."""
    tft.fill(BLACK)
    _draw_status_row(tft)
    tft.text("WAYPOINT  {}/{}".format(idx + 1, _page_count()), 8, 20, WHITE)
    tft.hline(0, 34, tft.width, rgb565(70, 80, 90))
    if _lap_waypoint is None:
        tft.text("Actual: sin capturar", 8, 50, GRAY)
    else:
        tft.text("Actual: {:.5f}, {:.5f}".format(*_lap_waypoint), 8, 50, WHITE)
    if _gps is None:
        gps_text, gps_color = "GPS no disponible", RED
    elif _gps.has_fix():
        gps_text, gps_color = "Fix OK, sats:{}".format(_gps.satellites), GREEN
    else:
        gps_text, gps_color = "Sin fix, sats:{}".format(_gps.satellites), GRAY
    tft.text(gps_text, 8, 66, gps_color)
    tft.text("Mantene BTN0 ~2s para setear", 8, 94, GRAY)
    _draw_footer_row(tft, idx)
    tft.show()


# Vista en vivo que reemplaza al cartel de entrada mientras
# _mode_locked es True (ver _draw_field) -- mapeado por "key" de
# PAGES, no por indice, porque _field_idx no cambia al entrar/salir.
_LIVE_DRAW = {
    "CARRERA": _draw_carrera_live,
    "SPRINT": _draw_sprint_live,
    "CARGA": _draw_carga_live,
}


def _draw_field(tft, idx):
    global _peek_page_idx
    if _peek_page_idx is not None:
        if time.ticks_diff(time.ticks_ms(), _peek_until_ms) >= 0:
            _peek_page_idx = None
        else:
            PAGES[_peek_page_idx]["draw"](tft, _peek_page_idx)
            return
    if _mode_locked:
        live_draw = _LIVE_DRAW.get(PAGES[idx]["key"])
        if live_draw is not None:
            live_draw(tft, idx)
            return
    PAGES[idx]["draw"](tft, idx)


async def ui_task(tft):
    global _dirty
    last_draw_ms = 0
    while True:
        now = time.ticks_ms()
        if _dirty or time.ticks_diff(now, last_draw_ms) >= 300:
            _draw_field(tft, _field_idx)
            _dirty = False
            last_draw_ms = now
        await asyncio.sleep_ms(50)


async def battery_task(interval_ms=10000):
    global _battery_voltage, _battery_percent, _battery_error, _dirty
    global _battery_adc_raw, _battery_adc_pin_voltage
    global _battery_adc_read_method
    while True:
        try:
            sample = HW.read_system_battery_sample()
            voltage = sample["voltage_v"]
            percent = percent_from_voltage(voltage)
        except Exception as exc:
            _battery_voltage = None
            _battery_percent = None
            _battery_error = "{}".format(exc)
            _battery_adc_raw = None
            _battery_adc_pin_voltage = None
            _battery_adc_read_method = None
            print("[battery] read error:", exc)
        else:
            _battery_voltage = voltage
            _battery_percent = percent
            _battery_error = None
            _battery_adc_raw = sample["raw_median"]
            _battery_adc_pin_voltage = sample["pin_voltage_v"]
            _battery_adc_read_method = sample["read_method"]
        _dirty = True
        await asyncio.sleep_ms(interval_ms)


async def gps_task():
    global _dirty, _gps_clock_synced, _gps_time_update_seen
    global _gps_last_rtc_sync_ms
    while True:
        if _gps is not None:
            if _gps.poll():
                _dirty = True
                _check_lap_crossing()
            update_count = _gps.time_update_count
            now = time.ticks_ms()
            if (update_count != _gps_time_update_seen and
                    (not _gps_clock_synced or time.ticks_diff(
                        now, _gps_last_rtc_sync_ms) >= 60000)):
                rtc_datetime = _gps.latest_rtc_datetime()
                if rtc_datetime is not None:
                    machine.RTC().datetime(rtc_datetime)
                    _gps_clock_synced = True
                    _gps_last_rtc_sync_ms = now
                    print("[GPS] RTC T190 sincronizado a ART:", _art_timestamp())
                    _dirty = True
            _gps_time_update_seen = update_count
        await asyncio.sleep_ms(20)


async def charge_monitor_task(interval_ms=1000):
    """Acumula Wh cargados mientras la corriente es de carga.
    _charge_session_active solo refleja si en ESTE instante hay corriente
    de carga (para el color del cartel en vivo, ver _draw_carga_live) --
    el acumulador _charge_wh_accum nunca se resetea aca, solo lo hace
    _on_charge_session_reset() al entrar a CARGA. Antes, una sola muestra
    por debajo del umbral (fase CV del cargador, rebote de conector,
    balanceo del BMS) hacia creer que la sesion habia terminado y
    reseteaba el acumulado a 0 en la siguiente muestra de carga, perdiendo
    todo lo medido hasta ahi sin ningun aviso."""
    global _charge_wh_accum, _charge_session_active
    while True:
        await asyncio.sleep_ms(interval_ms)
        if _rt is None or not _rt.source_fresh():
            continue
        st = _rt.state
        if not st.current_valid:
            continue
        i = st.i_bat
        charging = i < -_CHARGE_THRESHOLD_A
        _charge_session_active = charging
        if charging:
            _charge_wh_accum += abs(i) * st.v_bats / 3600.0


async def idle_sleep_task():
    """AUTO-SLEEP DESHABILITADO a pedido del equipo (2026-11-02).

    El T190 ya NO se apaga solo en ningun caso:
      - ni por perder la telemetria del Super Mini (ESP-NOW caido),
      - ni por inactividad a velocidad cero.
    En carrera el display tiene que quedar siempre prendido (puede haber
    paradas en pista/boxes, o cortes momentaneos de ESP-NOW, sin que eso
    signifique "abandonado"). El UNICO apagado es manual: boton S3 EXTRA
    largo (>=2.2s), ver _on_deep_sleep -> _SLEEP_REQUESTED.

    Se deja la tarea viva como no-op (en vez de no crearla en run()) para
    no tocar el arranque; _sleep_warn_* quedan en None asi ui_task nunca
    muestra el aviso "DUERME EN Xs". Para re-habilitar el auto-sleep,
    restaurar la logica previa desde el backup/git (usaba
    SUPERMINI_LOST_SLEEP_TIMEOUT_MS e IDLE_SLEEP_TIMEOUT_MS)."""
    global _sleep_warn_s, _sleep_warn_reason
    _sleep_warn_s = None
    _sleep_warn_reason = None
    while True:
        await asyncio.sleep_ms(60000)


async def sd_log_task():
    global _dirty
    global _sd_logger
    logger = _sd_logger
    if logger is None or not logger.ready:
        while True:
            await asyncio.sleep_ms(1000)

    last_sample_ms = None
    while True:
        now = time.ticks_ms()
        fresh = _rt is not None and _rt.source_fresh()

        try:
            if _LOG_MANUAL_OVERRIDE is True and not logger.recording:
                logger.start(timestamp_art=_art_timestamp())
                last_sample_ms = None
            elif _LOG_MANUAL_OVERRIDE is False and logger.recording:
                logger.stop()
                last_sample_ms = None
            # Auto = siempre grabando desde que la SD esta lista, sin
            # importar velocidad ni el modo/pantalla activo (CARRERA,
            # SPRINT, CARGA no tienen ninguna injerencia aca -- ver
            # _on_toggle_mode_lock, que no toca _sd_logger). Antes exigia
            # velocidad >= 0.5 km/h para arrancar; se sacó esa condición
            # para no perder datos parado o fuera de esos modos. Si se
            # quiere volver a gatillar por velocidad, reintroducir el
            # chequeo aca.
            elif _LOG_MANUAL_OVERRIDE is None and not logger.recording:
                logger.start(timestamp_art=_art_timestamp())
                last_sample_ms = None

            if (logger.recording and fresh and
                    (last_sample_ms is None or time.ticks_diff(
                        now, last_sample_ms) >= SD_LOG_SAMPLE_INTERVAL_MS)):
                fix = _gps.latest_fix() if _gps is not None else None
                race_elapsed = (
                    _settings.race_elapsed_s() if _settings is not None
                    else 0.0)
                race_remaining = (
                    _settings.race_remaining_s() if _settings is not None
                    else 0.0)
                logger.write_sample(
                    _rt.state, fix, timestamp_art=_art_timestamp(),
                    pa_target_w=_power_target_w(),
                    race_state=(
                        _settings.race_state if _settings is not None
                        else ""),
                    race_elapsed_s=race_elapsed,
                    race_remaining_s=race_remaining,
                    rem_lin_wh=(
                        _settings.battery_remaining_wh
                        if _settings is not None else None),
                    rem_peuk_wh=(
                        _settings.energy_remaining_peukert_wh
                        if _settings is not None else None))
                last_sample_ms = now
                _dirty = True
        except Exception as exc:
            logger.abort(exc)
            _dirty = True
            return

        await asyncio.sleep_ms(100)


def _apply_configuration(b_supermini_factors, ads_mode, capacity_wh, mark_charged,
                         source_boot, source_wh, meters_per_pulse,
                         debounce_us, max_speed_kmh, sleep_timeout_min,
                         precharge_wh=0.0, peukert_n=1.0, peukert_i_ref=0.0):
    global _dirty, _supermini_config_error, _supermini_config_error_revision
    global IDLE_SLEEP_TIMEOUT_MS
    _settings.update_configuration(
        b_supermini_factors, ads_mode, capacity_wh, meters_per_pulse, debounce_us,
        max_speed_kmh, sleep_timeout_min, mark_charged,
        source_boot=source_boot, source_wh=source_wh, precharge_wh=precharge_wh,
        peukert_n=peukert_n, peukert_i_ref=peukert_i_ref)
    IDLE_SLEEP_TIMEOUT_MS = sleep_timeout_min * 60 * 1000
    _supermini_config_error = None
    _supermini_config_error_revision = None
    _dirty = True


def _current_source_cursor():
    if _rt is None:
        return None, None
    return _rt.state.source_boot, _rt.raw_wh_total


def _current_raw_batteries():
    if (_rt is None or not _rt.source_fresh() or
            not _rt.state.adc_valid):
        return None
    return _rt.raw_battery_voltages


def _current_sd_logger():
    return _sd_logger


def _supermini_feedback_status():
    if _en is None or not _en.paired:
        return "Sin emparejar"
    if (_supermini_config_error is not None and
            _supermini_config_error_revision ==
            _settings.supermini_config_revision):
        return "Rechazado: {}".format(_supermini_config_error)
    if _supermini_config_ack_revision == _settings.supermini_config_revision:
        return "Confirmado (ID {})".format(_supermini_config_ack_revision)
    return "Pendiente (ID {})".format(_settings.supermini_config_revision)


def _on_supermini_config_ack(revision, accepted):
    global _supermini_config_ack_revision, _supermini_config_error
    global _supermini_config_error_revision, _dirty
    if _settings is None or revision != _settings.supermini_config_revision:
        print("[config] ACK de Super Mini ignorado para ID", revision)
        return
    if accepted:
        _supermini_config_ack_revision = revision
        _supermini_config_error = None
        _supermini_config_error_revision = None
        print("[config] Super Mini confirmó ajustes, ID={}".format(revision))
    else:
        _supermini_config_error = "ID {}".format(revision)
        _supermini_config_error_revision = revision
        print("[config] Super Mini rechazó ajustes, ID={}".format(revision))
    _dirty = True


def _on_supermini_reset_ack(request_id, accepted):
    """Callback de EspNowLink para el canal RST/RSTA/RSTN (ver Fase 5):
    confirma o rechaza el pedido de reset remoto disparado por el combo
    BTN0 sostenido + S3 corto (_on_remote_reset_request)."""
    global _reset_ack_status, _dirty
    if request_id != _reset_request_id:
        print("[reset] ACK de Super Mini ignorado para ID", request_id)
        return
    if accepted:
        _reset_ack_status = "ok"
        _show_toast("Reset Super Mini OK")
        print("[reset] Super Mini confirmo el reset, ID={}".format(request_id))
    else:
        _reset_ack_status = "rejected"
        _show_toast("Reset Super Mini RECHAZADO")
        print("[reset] Super Mini rechazo el reset, ID={}".format(request_id))
    _dirty = True


async def remote_reset_watchdog_task(interval_ms=500):
    """Si el pedido de reset remoto queda "pending" mas de
    RESET_ACK_TIMEOUT_MS sin ACK/NACK del Super Mini (apagado, fuera de
    rango), avisa por toast -- la accion en si es idempotente, reintentar
    el combo no corrompe nada."""
    global _reset_ack_status, _dirty
    while True:
        if (_reset_ack_status == "pending" and
                time.ticks_diff(time.ticks_ms(), _reset_ack_deadline_ms) >= 0):
            _reset_ack_status = "timeout"
            _show_toast("Reset Super Mini: SIN CONFIRMACION")
            _dirty = True
        await asyncio.sleep_ms(interval_ms)


async def supermini_config_task(interval_ms=2500):
    last_sent_revision = None
    while True:
        revision = _settings.supermini_config_revision
        if (_en is not None and _en.paired and
                _supermini_config_ack_revision != revision):
            if _en.send_configuration(
                    revision, _settings.supermini_meters_per_pulse,
                    _settings.supermini_debounce_us,
                    _settings.supermini_max_speed_kmh,
                    _settings.b_supermini_factors_milli,
                    _settings.ads_mode):
                if last_sent_revision != revision:
                    print("[config] enviando ajustes al Super Mini, ID={}".format(
                        revision))
                    last_sent_revision = revision
        await asyncio.sleep_ms(interval_ms)


def _on_config_saved():
    global _CONFIG_AP_STOP_REQUESTED
    _CONFIG_AP_STOP_REQUESTED = True


async def config_ap_task():
    global _CONFIG_AP_REQUESTED, _CONFIG_AP_STOP_REQUESTED
    global _CONFIG_AP_RUNNING, _dirty, _field_idx
    while True:
        if _CONFIG_AP_REQUESTED:
            _CONFIG_AP_REQUESTED = False
            _CONFIG_AP_STOP_REQUESTED = False
            server = ConfigServer(
                _settings, _current_raw_batteries, _current_source_cursor,
                _supermini_feedback_status,
                _apply_configuration, _on_config_saved, _current_sd_logger)
            try:
                await server.start()
            except Exception as exc:
                print("[config] no se pudo iniciar el AP:", exc)
                try:
                    await server.stop()
                except Exception as stop_exc:
                    print("[config] no se pudo limpiar el AP:", stop_exc)
                _CONFIG_AP_RUNNING = False
                _dirty = True
                await asyncio.sleep_ms(250)
                continue
            _CONFIG_AP_RUNNING = True
            _dirty = True
            try:
                while (not _CONFIG_AP_STOP_REQUESTED and
                       not _STOP_REQUESTED and not _SLEEP_REQUESTED):
                    await asyncio.sleep_ms(100)
            finally:
                await server.stop()
                _CONFIG_AP_RUNNING = False
                _CONFIG_AP_STOP_REQUESTED = False
                _field_idx = _PAGE_INDEX["CARRERA"]
                _dirty = True
        await asyncio.sleep_ms(100)


# ── Botones ──────────────────────────────────────────────────────────────────

def _note_button_activity():
    """Cualquier gesto de botón reinicia los temporizadores de auto-sleep
    (ver idle_sleep_task) -- si el usuario sigue interactuando con el
    equipo, no tiene sentido contar eso como "parado"/"abandonado"."""
    global _last_button_activity_ms
    _last_button_activity_ms = time.ticks_ms()


def _with_activity(fn):
    def wrapped():
        global _peek_page_idx
        _note_button_activity()
        _peek_page_idx = None  # cualquier gesto corta un peek de ENERGIA en curso
        fn()
    return wrapped


def _on_next():
    global _field_idx, _dirty
    if _in_locked_mode():
        return
    _field_idx = (_field_idx + 1) % _page_count()
    _dirty = True


def _on_home():
    """Escape universal: va a CARRERA y sale de cualquier modo especial
    activo, sea cual sea -- _mode_locked (CARRERA/SPRINT/CARGA) o el AP
    de CONFIG. Gatillada por BTN0 largo (_on_btn0_long), sin condiciones;
    si no recordas el gesto de salida de un modo puntual, este siempre
    funciona."""
    global _field_idx, _dirty, _CONFIG_AP_REQUESTED
    global _CONFIG_AP_STOP_REQUESTED, _mode_locked
    _field_idx = _PAGE_INDEX["CARRERA"]
    _mode_locked = False
    if _CONFIG_AP_RUNNING or _CONFIG_AP_REQUESTED:
        _CONFIG_AP_REQUESTED = False
        _CONFIG_AP_STOP_REQUESTED = True
        print("[config] cerrando AP sin guardar; regreso a CARRERA")
    _dirty = True


def _on_prev():
    global _field_idx, _dirty
    if _in_locked_mode():
        return
    _field_idx = (_field_idx - 1) % _page_count()
    _dirty = True


def _on_go_config():
    global _field_idx, _dirty
    _field_idx = _PAGE_INDEX["CONFIG"]
    _dirty = True


def _on_reset_trip():
    """Marca el inicio del periodo a considerar (tipicamente post-recarga):
    pone en cero Wh usados y distancia de viaje, anclando ambos al dato
    crudo actual del Super Mini. El Super Mini no se entera -- sigue
    mandando sus totales de vida entera, el offset vive solo aca."""
    global _dirty
    if _rt is None or _settings is None:
        return
    if _rt.state.source_boot is None:
        print("[trip] sin telemetria del Super Mini todavia; no se puede "
              "marcar el inicio del periodo")
        _show_toast("Reset: sin telemetria Super Mini")
        return
    _settings.mark_pack_charged(
        source_boot=_rt.state.source_boot, source_wh=_rt.raw_wh_total)
    _settings.reset_trip_distance(
        source_boot=_rt.state.source_boot, source_dist_m=_rt.state.dist_m)
    print("[trip] reset: inicio de periodo marcado (Wh usados y distancia en 0)")
    _show_toast("Periodo reiniciado: Wh y distancia en 0")
    _dirty = True


def _on_deep_sleep():
    global _SLEEP_REQUESTED
    _SLEEP_REQUESTED = True
    print("[btn] S3 EXTRA largo (>=2.2s) -- solicitando deep sleep")


def _on_log_toggle():
    """Alternar log SD -- ahora disparado por el combo S3 sostenido +
    BTN0 corto (antes era BTN0 largo global; ese gesto ahora es "ir a
    CARRERA", ver _on_home)."""
    if _sd_logger is None or not _sd_logger.ready:
        detail = _sd_error if _sd_logger is None else _sd_logger.error
        print("[SD] no se puede cambiar el registro:", detail or "no disponible")
        return
    if _sd_logger.recording or _LOG_MANUAL_OVERRIDE is True:
        log_stop()
    else:
        log_start()


def _on_config_ap_toggle():
    """Invocada desde _on_btn0_extra cuando estas parado en CONFIG (mismo
    gesto, BTN0 ~2.2s, que activa/desactiva los otros modos especiales --
    ver _in_locked_mode): abre/cierra el AP de configuracion."""
    global _CONFIG_AP_REQUESTED, _CONFIG_AP_STOP_REQUESTED
    if _CONFIG_AP_RUNNING or _CONFIG_AP_REQUESTED:
        _CONFIG_AP_REQUESTED = False
        _CONFIG_AP_STOP_REQUESTED = True
        print("[config] cerrando AP sin guardar")
    else:
        _CONFIG_AP_REQUESTED = True
        print("[config] iniciando AP; conecta el teléfono a", AP_SSID)


def _on_charge_session_reset():
    """Reinicia el acumulador de Wh+ de la sesion de carga a 0. Invocada
    al ENTRAR a modo CARGA (_on_toggle_mode_lock) -- cada entrada arranca
    una medicion nueva, no suma sobre una carga anterior."""
    global _charge_wh_accum, _charge_session_active, _dirty
    _charge_wh_accum = 0.0
    _charge_session_active = False
    _dirty = True
    print("[carga] sesion reiniciada (Wh+ = 0)")


def _on_btn0_long():
    """BTN0 largo (~1.2-2.2s): escape universal -- siempre va a CARRERA y
    sale de cualquier modo especial activo (_on_home). El toggle de cada
    modo puntual vive en BTN0 extra (_on_btn0_extra), no aca."""
    _on_home()


def _on_btn0_double_peek_energia():
    """BTN0 doble: muestra ENERGIA (restante) 5s sin cambiar de pantalla
    activa, y vuelve sola (ver _draw_field/_with_activity)."""
    global _peek_page_idx, _peek_until_ms, _dirty
    _peek_page_idx = _PAGE_INDEX["ENERGIA"]
    _peek_until_ms = time.ticks_add(time.ticks_ms(), PEEK_DURATION_MS)
    _dirty = True


def _on_s3_double_start():
    """S3 doble: largada de la tanda en un solo gesto -- captura el
    waypoint GPS de largada/vuelta (ver _on_capture_waypoint), arranca el
    reloj de carrera si todavia no estaba corriendo (no reinicia una
    carrera ya en curso ni pausada), y va al cartel de CARRERA
    (_draw_carrera_launcher). No entra directo al modo en vivo -- eso
    sigue requiriendo sostener BTN0 ahi (ver _on_btn0_extra)."""
    global _field_idx, _dirty
    _on_capture_waypoint()
    if _settings is not None and _settings.race_state in ("idle", "finished"):
        _settings.race_start()
        _show_toast("CARRERA INICIADA ({})".format(_format_mmss(RACE_DURATION_S)))
    _field_idx = _PAGE_INDEX["CARRERA"]
    _dirty = True


def _enter_deep_sleep():
    if _lora is not None:
        try:
            _lora.sleep()
        except Exception as exc:
            print("[sleep] no se pudo dormir el SX1262:", exc)
    try:
        HW.backlight_off()
        HW.display_power_off()
    except Exception as exc:
        print("[sleep] no se pudo apagar el display:", exc)
    try:
        HW.vext_disable()
    except Exception as exc:
        print("[sleep] no se pudo apagar VEXT/GPS:", exc)

    wake_pin = Pin(HW.MAIN_WAKE_PIN, Pin.IN, Pin.PULL_UP)
    time.sleep_ms(50)
    if wake_pin.value() == 0:
        raise RuntimeError("S3 sigue presionado; sueltalo antes de entrar en deep sleep")
    esp32.wake_on_ext0(wake_pin, 0)
    print("[sleep] deep sleep; presiona S3 (GPIO{}) para despertar".format(
        HW.MAIN_WAKE_PIN))
    machine.deepsleep()


def _on_capture_waypoint():
    """S3 corto: captura el waypoint de largada/llegada (antes era S3
    largo; el conteo de vueltas usa este punto, ver _check_lap_crossing)."""
    global _lap_waypoint, _lap_count, _last_lap_time_s, _lap_start_ms
    global _lap_last_cross_ms, _dirty
    if _gps is None:
        print("[GPS] no disponible; revisar UART y alimentacion VEXT")
        _show_toast("Waypoint: GPS no disponible")
        return
    fix = _gps.latest_fix()
    if fix is None:
        print("[GPS] sin fix reciente; waypoint no capturado")
        _show_toast("Waypoint: sin fix GPS")
        return
    _lap_waypoint = (fix["latitude"], fix["longitude"])
    now = time.ticks_ms()
    _lap_count = 0
    _last_lap_time_s = None
    _lap_start_ms = now
    _lap_last_cross_ms = now
    print("[GPS] waypoint largada/llegada: lat={:.6f} lon={:.6f} sats={}".format(
        _lap_waypoint[0], _lap_waypoint[1], fix["satellites"]))
    _show_toast("Waypoint OK sat{}: {:.5f},{:.5f}".format(
        fix["satellites"], _lap_waypoint[0], _lap_waypoint[1]))
    _dirty = True


def _on_race_toggle():
    """Inicia, pausa o reanuda el reloj de carrera (ver T190Settings.
    race_* y docs/ARQUITECTURA_TELEMETRIA_ECOYPF.md §0). Sin gesto
    asignado: _on_toggle_mode_lock ya arranca el reloj solo al entrar a
    CARRERA; pausar/reanudar a mitad de carrera (ej. para un pit stop)
    queda pendiente de decidir donde vive si se necesita."""
    global _dirty
    if _settings is None:
        return
    state = _settings.race_state
    if state in ("idle", "finished"):
        _settings.race_start()
        _show_toast("CARRERA INICIADA ({})".format(_format_mmss(RACE_DURATION_S)))
    elif state == "running":
        _settings.race_pause()
        _show_toast("CARRERA PAUSADA")
    elif state == "paused":
        _settings.race_resume()
        _show_toast("CARRERA REANUDADA")
    _dirty = True


def _on_toggle_mode_lock():
    """Entra o sale del modo especial de la pagina actual (CARRERA,
    SPRINT o CARGA -- CONFIG/AP usa su propio mecanismo async, ver
    _on_config_ap_toggle): cambia que dibuja _draw_field, del cartel de
    entrada (_draw_*_launcher) a los valores en vivo (_LIVE_DRAW) y
    viceversa -- y bloquea/libera next/prev mientras tanto
    (_in_locked_mode). Mismo gesto para ambos sentidos: _field_idx no
    cambia al entrar ni al salir, asi que alcanza con invertir
    _mode_locked.

    Al entrar arranca solo el cronometro/acumulador que corresponda -- no
    hace falta un gesto aparte para "empezar a registrar": en CARRERA, el
    reloj de 80 min (si no estaba corriendo ya, mismo guard que
    _on_s3_double_start); en SPRINT, el cronometro propio de la tanda; en
    CARGA, el acumulador de Wh+ (_on_charge_session_reset). Al salir de
    CARGA, lo acumulado se registra como la nueva capacidad del pack."""
    global _mode_locked, _dirty, _sprint_start_ms
    _mode_locked = not _mode_locked
    key = PAGES[_field_idx]["key"]
    if _mode_locked:
        if (key == "CARRERA" and _settings is not None and
                _settings.race_state in ("idle", "finished")):
            _settings.race_start()
        elif key == "SPRINT":
            _sprint_start_ms = time.ticks_ms()
        elif key == "CARGA":
            _on_charge_session_reset()
        _show_toast("Modo {} activado".format(key))
    elif key == "CARGA" and _settings is not None:
        source_boot = _rt.state.source_boot if _rt is not None else None
        source_wh = _rt.raw_wh_total if _rt is not None else None
        _settings.set_battery_capacity_from_charge(
            _charge_wh_accum, source_boot=source_boot, source_wh=source_wh)
        _show_toast("Capacidad registrada: {:.0f} Wh".format(_charge_wh_accum))
    else:
        _show_toast("Modo {} desactivado".format(key))
    _dirty = True


def _on_reinicio_execute():
    """BTN0 extra-largo en REINICIO: ejecuta el reset de una, sin modo
    que mantener ni del que salir (a diferencia de CARRERA/SPRINT/CARGA/
    CONFIG) -- misma logica que ya existia, ver _on_btn0_extra_reset."""
    _on_btn0_extra_reset()


def _on_log_record_toggle():
    """BTN0 extra-largo en GRABAR: arranca o detiene el log SD. Usa
    log_start()/log_stop() (dejan _LOG_MANUAL_OVERRIDE en True/False), asi
    al detener el modo auto NO reinicia la grabacion y se puede descargar/
    borrar por el AP. Marca _dirty para que la pantalla GRABAR refleje el
    cambio al toque."""
    global _dirty
    if _sd_logger is None or not _sd_logger.ready:
        detail = _sd_error if _sd_logger is None else _sd_logger.error
        _show_toast("SD no disponible: {}".format(detail or "sin tarjeta"))
        return
    if _sd_logger.recording or _LOG_MANUAL_OVERRIDE is True:
        if log_stop():
            _show_toast("Grabacion DETENIDA")
    else:
        if log_start():
            _show_toast("Grabacion INICIADA")
    _dirty = True


def _on_waypoint_execute():
    """BTN0 extra-largo en WAYPOINT: ejecuta la captura de una, sin
    tocar el reloj de carrera ni navegar a otro lado -- a diferencia de
    S3 doble (_on_s3_double_start), que ademas arranca Endurance y te
    manda al cartel de CARRERA. Reusa la captura ya existente."""
    _on_capture_waypoint()


def _on_btn0_extra():
    """BTN0 ~2.2s: gesto unico para activar el modo especial de la
    pagina actual, misma regla en los seis casos -- primero pararse en
    la pagina correcta, despues sostener (ver _draw_help):
      CARRERA/SPRINT/CARGA -> _on_toggle_mode_lock (entra/sale)
      CONFIG                -> _on_config_ap_toggle (abre/cierra AP)
      REINICIO               -> _on_reinicio_execute (reset inmediato)
      WAYPOINT               -> _on_waypoint_execute (captura inmediata)
      GRABAR                 -> _on_log_record_toggle (graba/detiene log)
    En cualquier otra pantalla, no hace nada."""
    key = PAGES[_field_idx]["key"]
    if key in ("CARRERA", "SPRINT", "CARGA"):
        _on_toggle_mode_lock()
    elif key == "CONFIG":
        _on_config_ap_toggle()
    elif key == "REINICIO":
        _on_reinicio_execute()
    elif key == "WAYPOINT":
        _on_waypoint_execute()
    elif key == "GRABAR":
        _on_log_record_toggle()


def _on_btn0_extra_reset():
    """Reset local completo -- viaje (ya existia, ver _on_reset_trip) +
    reloj de carrera + acumulador Peukert. No toca la capacidad del pack
    (battery_capacity_wh, ver modo CARGA) ni las calibraciones. Invocada
    desde REINICIO (_on_reinicio_execute)."""
    global _dirty
    _on_reset_trip()
    if _settings is not None:
        _settings.race_reset()
        _settings.reset_effective_energy()
    _show_toast("Reset local: viaje, carrera y Peukert en 0")
    _dirty = True


def _on_remote_reset_request():
    """Combo BTN0 sostenido + S3 corto: pide al Super Mini que resetee sus
    acumuladores de vida entera (wh_total/dist_m/pulsos en trip.json) via
    ESP-NOW (canal RST/RSTA/RSTN, analogo a CFG/CFGA/CFGN). Accion
    destructiva e irreversible -> interlock de doble confirmacion: el
    primer combo solo "arma" un pedido que vence en
    REMOTE_RESET_CONFIRM_WINDOW_MS; hay que repetir el combo dentro de esa
    ventana para que se envie de verdad."""
    global _remote_reset_armed_until_ms, _reset_request_id, _reset_ack_status
    global _reset_ack_deadline_ms, _dirty
    now = time.ticks_ms()
    armed = (_remote_reset_armed_until_ms != 0 and
             time.ticks_diff(now, _remote_reset_armed_until_ms) <= 0)
    if not armed:
        _remote_reset_armed_until_ms = time.ticks_add(
            now, REMOTE_RESET_CONFIRM_WINDOW_MS)
        _show_toast("RESET SUPER MINI: repetir combo en 5s para confirmar")
        _dirty = True
        return
    _remote_reset_armed_until_ms = 0
    if _en is None or not _en.paired:
        _show_toast("Reset: Super Mini no emparejado")
        _dirty = True
        return
    _reset_request_id = (_reset_request_id + 1) & 0xFFFFFFFF
    if _en.send_reset_command(_reset_request_id):
        _reset_ack_status = "pending"
        _reset_ack_deadline_ms = time.ticks_add(now, RESET_ACK_TIMEOUT_MS)
        _show_toast("Reset enviado, esperando confirmacion...")
    else:
        _reset_ack_status = "failed"
        _show_toast("Reset: fallo el envio ESP-NOW")
    _dirty = True


async def race_clock_task(interval_ms=1000):
    """Si la carrera esta RUNNING y se agotaron los 80 minutos, pasa a
    FINISHED automaticamente (ver T190Settings.race_finish)."""
    global _dirty
    while True:
        if (_settings is not None and _settings.race_state == "running"
                and _settings.race_remaining_s() <= 0):
            _settings.race_finish()
            _show_toast("CARRERA FINALIZADA")
            _dirty = True
        await asyncio.sleep_ms(interval_ms)


# ── Paginas: construidas aca (no antes) porque la lista necesita que las
# funciones _draw_* ya esten definidas -- ver nota al principio del
# archivo. _page_count()/_page_label()/_draw_field() (definidas mas
# arriba) solo leen PAGES/_PAGE_INDEX en el momento en que se llaman, asi
# que el orden de definicion no importa ahi.
# NOTA: BTN0 corto es navegacion pura (_on_next) en todas las paginas --
# ya no es contextual. CARRERA/SPRINT/CONFIG/CARGA/REINICIO son cartel de
# entrada en navegacion normal; BTN0 extra (~2.2s) activa cada modo (ver
# comentario al principio del archivo). _on_race_toggle sigue sin gesto
# asignado.
PAGES = [
    {"key": "CARRERA", "label": "CARRERA", "draw": _draw_carrera_launcher},
    {"key": "SPRINT", "label": "SPRINT", "draw": _draw_sprint_launcher},
    {"key": "RUTA", "label": "RUTA", "draw": _draw_ruta},
    {"key": "CONSUMO", "label": "CONSUMO", "draw": _draw_consumo},
    {"key": "EFICIENCIA", "label": "EFICIENCIA", "draw": _draw_eficiencia},
    {"key": "BATERIAS", "label": "BATERIAS", "draw": _draw_baterias},
    {"key": "ENERGIA", "label": "ENERGIA", "draw": _draw_energia},
    {"key": "VIAJE", "label": "VIAJE", "draw": _draw_viaje},
    {"key": "GPS", "label": "GPS", "draw": _draw_gps},
    {"key": "WAYPOINT", "label": "WAYPOINT", "draw": _draw_waypoint},
    {"key": "PULSOS", "label": "PULSOS", "draw": _draw_pulsos},
    {"key": "DIAGNOSTICO", "label": "DIAGNOSTICO", "draw": _draw_diagnostics},
    {"key": "AYUDA", "label": "AYUDA BOTONES", "draw": _draw_help},
    {"key": "GRABAR", "label": "GRABAR", "draw": _draw_grabar},
    {"key": "CONFIG", "label": "CONFIGURACION", "draw": _draw_configuration},
    {"key": "CARGA", "label": "CARGA", "draw": _draw_carga_launcher},
    {"key": "REINICIO", "label": "REINICIO", "draw": _draw_reinicio},
]
_PAGE_INDEX = {p["key"]: i for i, p in enumerate(PAGES)}


# ── Arranque asyncio (corre dentro del thread de fondo) ─────────────────────

async def _main_async():
    global _rt, _en, _lora, _shared_spi, _sd_logger, _tft, _gps, _dirty
    global _settings
    global IDLE_SLEEP_TIMEOUT_MS
    print("[main] arrancando...")
    print("[power] reset_cause={} wake_reason={}".format(
        machine.reset_cause(), machine.wake_reason()))

    try:
        HW.vext_enable()
        print("[HW] VEXT habilitado para QuickLink/GPS")
    except Exception as exc:
        print("[HW] no se pudo habilitar VEXT:", exc)
    _gps = make_gps()

    _tft = make_display()
    print("[main] display OK {}x{}".format(_tft.width, _tft.height))

    _shared_spi = make_shared_spi()
    _lora = make_lora(_shared_spi)
    _sd_logger = make_sd_logger(_shared_spi)
    try:
        _settings = T190Settings()
    except (OSError, ValueError) as exc:
        print("[config] archivo de ajustes inválido; se usarán defaults:", exc)
        _settings = T190Settings(load_existing=False)
    IDLE_SLEEP_TIMEOUT_MS = _settings.idle_sleep_timeout_min * 60 * 1000
    _rt = TelemetryRuntime(lora=_lora)

    def on_telemetry(payload):
        accepted = _rt.on_telemetry(payload)
        if accepted:
            try:
                _settings.note_source_energy(
                    _rt.state.source_boot, _rt.raw_wh_total,
                    _rt.pack_voltage_ratio)
                _settings.note_source_distance(
                    _rt.state.source_boot, _rt.state.dist_m)
                _settings.note_effective_energy(
                    _rt.state.p_inst, _rt.state.i_bat)
            except (OSError, ValueError) as exc:
                print("[energy] no se pudo guardar el estado del pack:", exc)
        return accepted

    _en = make_espnow(
        on_telemetry, _on_supermini_config_ack, _on_supermini_reset_ack)

    # S3 (GPIO21): corto = pantalla anterior, doble = largada (waypoint +
    # arranca carrera si no estaba corriendo + va a CARRERA), largo = ir a
    # CONFIGURACION, extra (>=2.2s) = deep sleep, combo (con BTN0 sostenido)
    # = pedir reset remoto del Super Mini. La accion se ejecuta al soltar.
    irq_trigger = Pin.IRQ_FALLING | Pin.IRQ_RISING
    page_btn = InterruptPageButton(
        Pin(HW.PAGE_BTN_PIN, Pin.IN, Pin.PULL_UP),
        short=_with_activity(_on_prev),
        double=_with_activity(_on_s3_double_start),
        long=_with_activity(_on_go_config),
        extra=_with_activity(_on_deep_sleep),
        combo=_with_activity(_on_remote_reset_request),
        label="S3", irq_trigger=irq_trigger, debounce_ms=25,
    )
    # BTN0: corto = pantalla siguiente (bloqueado si hay un modo especial
    # activo, ver _in_locked_mode), doble = ver ENERGIA restante 5s y
    # volver solo, largo = escape universal a CARRERA (_on_home, sale de
    # cualquier modo), extra (~2.2s) = activa el modo especial de la
    # pagina actual -- CARRERA/SPRINT/CARGA/CONFIG/REINICIO, mismo gesto
    # en los cinco, nada en el resto (_on_btn0_extra), combo (con S3
    # sostenido) = alternar log SD.
    btn0 = InterruptPageButton(
        Pin(HW.BTN0_PIN, Pin.IN, Pin.PULL_UP),
        short=_with_activity(_on_next),
        double=_with_activity(_on_btn0_double_peek_energia),
        long=_with_activity(_on_btn0_long),
        extra=_with_activity(_on_btn0_extra),
        combo=_with_activity(_on_log_toggle),
        label="BTN0", irq_trigger=irq_trigger, debounce_ms=25,
    )
    # Wiring cruzado para que cada boton sepa si el otro esta sostenido --
    # sin esto, "combo" nunca dispara (ver buttons.py).
    page_btn.other = btn0
    btn0.other = page_btn
    _dirty = True
    tasks = [
        asyncio.create_task(_rt.lora_task()),
        asyncio.create_task(ui_task(_tft)),
        asyncio.create_task(battery_task()),
        asyncio.create_task(gps_task()),
        asyncio.create_task(page_btn.task()),
        asyncio.create_task(btn0.task()),
        asyncio.create_task(config_ap_task()),
        asyncio.create_task(supermini_config_task()),
    ]
    tasks.append(asyncio.create_task(idle_sleep_task()))
    tasks.append(asyncio.create_task(sd_log_task()))
    tasks.append(asyncio.create_task(charge_monitor_task()))
    tasks.append(asyncio.create_task(race_clock_task()))
    tasks.append(asyncio.create_task(remote_reset_watchdog_task()))

    if _en is not None:
        tasks.append(asyncio.create_task(_en.listen_task()))

    try:
        while not _STOP_REQUESTED and not _SLEEP_REQUESTED:
            await asyncio.sleep_ms(200)
    finally:
        for t in tasks:
            try:
                t.cancel()
            except Exception:
                pass
        page_btn.close()
        btn0.close()
        print("[main] detenido")


def _bg():
    global _RUNNING, _STOP_REQUESTED, _SLEEP_REQUESTED
    try:
        asyncio.run(_main_async())
    except Exception as exc:
        print("[main] error fatal en hilo de fondo:", exc)
        try:
            sys.print_exception(exc)
        except Exception:
            pass
    finally:
        if _settings is not None:
            try:
                _settings.save()
            except Exception as exc:
                print("[config] error al persistir ajustes:", exc)
        if _sd_logger is not None:
            try:
                _sd_logger.deinit()
            except Exception as exc:
                print("[SD] error al cerrar/desmontar:", exc)
        if _gps is not None:
            try:
                _gps.deinit()
            except Exception as exc:
                print("[GPS] error al cerrar UART:", exc)
        try:
            HW.vext_disable()
        except Exception as exc:
            print("[HW] no se pudo deshabilitar VEXT:", exc)
        if _SLEEP_REQUESTED:
            try:
                _enter_deep_sleep()
            except Exception as exc:
                print("[sleep] deep sleep fallo:", exc)
                try:
                    sys.print_exception(exc)
                except Exception:
                    pass
        _RUNNING = False
        _STOP_REQUESTED = False
        _SLEEP_REQUESTED = False


def start():
    """Arranca la app en un thread de fondo. No bloquea -> REPL libre."""
    global _RUNNING, _STOP_REQUESTED, _SLEEP_REQUESTED, _LOG_MANUAL_OVERRIDE
    if _RUNNING:
        print("[main] ya esta corriendo")
        return False
    _STOP_REQUESTED = False
    _SLEEP_REQUESTED = False
    _LOG_MANUAL_OVERRIDE = None
    _CONFIG_AP_REQUESTED = False
    _CONFIG_AP_STOP_REQUESTED = False
    _RUNNING = True
    try:
        _thread.stack_size(_BG_THREAD_STACK)
    except Exception as exc:
        print("[main] stack size error:", exc)
    _thread.start_new_thread(_bg, ())
    return True


def stop(wait_ms=0):
    """Pide apagar la app. Con wait_ms>0 espera (bloqueante) a que termine."""
    global _STOP_REQUESTED
    if not _RUNNING:
        print("[main] no esta corriendo")
        return False
    _STOP_REQUESTED = True
    remaining = int(wait_ms)
    while _RUNNING and remaining > 0:
        time.sleep_ms(10)
        remaining -= 10
    return True


def next_field():
    """Avanza a la siguiente pantalla (equivalente a BTN0 doble)."""
    _on_next()
    print("[main] campo ->", _page_label(_field_idx))


def prev_field():
    """Retrocede a la pantalla anterior (equivalente a S3 doble)."""
    _on_prev()
    print("[main] campo ->", _page_label(_field_idx))


def reset_trip():
    """Resetea distancia y Wh de viaje (solo esto -- no toca el reloj de
    carrera ni Peukert; para el reset completo ver _on_btn0_extra_reset,
    equivalente a BTN0 extra-largo)."""
    _on_reset_trip()


def espnow_status():
    """Estado del enlace ESP-NOW con el Super Mini (llamar desde el REPL)."""
    if _en is None:
        print("[espnow] no inicializado")
        return
    print("[espnow] emparejado={} peer={} fresh={} rx_count={} seq={} adc={} current={}".format(
        _en.paired, mac_str(_en.peer), _en.fresh,
        _rt.state.espnow_rx_count if _rt else 0,
        _rt.state.source_seq if _rt else None,
        _rt.state.adc_valid if _rt else False,
        _rt.state.current_valid if _rt else False))


def espnow_repair():
    """Olvida el peer ESP-NOW actual y vuelve a modo pairing (escucha
    broadcast). Usar si cambiaste de Super Mini o la MAC dejo de responder."""
    global _supermini_config_ack_revision, _supermini_config_error
    global _supermini_config_error_revision
    if _en is None:
        print("[espnow] no inicializado")
        return
    _supermini_config_ack_revision = None
    _supermini_config_error = None
    _supermini_config_error_revision = None
    _en.repair()


def status():
    """Snapshot on-demand de la telemetria actual (llamar desde el REPL)."""
    if _rt is None:
        print("[main] aun no inicializado")
        return
    st = _rt.state
    page = PAGES[_field_idx]
    if page["key"] == "DIAGNOSTICO":
        page_text, value_text = "DIAGNOSTICO", "--"
    elif page["key"] == "CONFIG":
        page_text, value_text = "CONFIGURACION", (
            "AP activo" if _CONFIG_AP_RUNNING else "AP apagado")
    elif page["key"] == "AYUDA":
        page_text, value_text = "AYUDA BOTONES", "BTN0 / S3"
    elif page["key"] == "CARGA":
        page_text = "CARGA"
        value_text = "I={:.2f}A Wh+={:.1f}".format(
            st.i_bat,
            (_settings.precharge_wh if _settings else 0.0) + _charge_wh_accum)
    elif page["key"] == "CARRERA":
        page_text = "CARRERA"
        target = _power_target_w()
        value_text = "{} PA={:.0f}W obj={}".format(
            _settings.race_state if _settings else "?", st.p_avg5s,
            "{:.0f}W".format(target) if target is not None else "--")
    else:
        page_text, value_text = page["label"], "(ver pantalla)"
    battery_text = "n/a" if _battery_voltage is None else (
        "{:.2f}V/{}% ADC={} pin={:.3f}V {}".format(
            _battery_voltage, _battery_percent, _battery_adc_raw,
            _battery_adc_pin_voltage, _battery_adc_read_method))
    gps_fix = _gps.latest_fix() if _gps is not None else None
    gps_text = "sin fix" if gps_fix is None else "{:.6f},{:.6f}".format(
        gps_fix["latitude"], gps_fix["longitude"])
    race_text = "n/a" if _settings is None else "{} T={} R={}".format(
        _settings.race_state, _format_mmss(_settings.race_elapsed_s()),
        _format_mmss(_settings.race_remaining_s()))
    print("[STATUS] pantalla={}({}) T190_BAT={} GPS={} I={:.2f}A "
          "B1={:.2f} B2={:.2f} B3={:.2f} B4={:.2f} VBATS={:.2f}V "
          "P={:.0f}W PA={:.0f}W V={:.1f}km/h D={:.0f}m "
          "WI={:.1f} WA={:.1f} WT={:.1f}Wh PACK={}% REM_lin={} REM_peuk={} "
          "CAP={}Wh RACE={} VUELTAS={} "
          "VF={} AV={} IV={} AGE={}ms LoRaTXlocal={}#{} "
          "ESPNOW={}#{}".format(
        page_text, value_text, battery_text, gps_text,
        st.i_bat, st.v_b1, st.v_b2, st.v_b3, st.v_b4, st.v_bats,
        st.p_inst, st.p_avg5s, st.speed_kmh, st.dist_m,
        st.whkm_inst, st.whkm_avg, st.wh_total,
        _settings.battery_percent if _settings else None,
        _settings.battery_remaining_wh if _settings else None,
        _settings.energy_remaining_peukert_wh if _settings else None,
        _settings.battery_capacity_wh if _settings else None,
        race_text, _lap_count,
        _settings.b_supermini_factors_milli if _settings else None,
        st.adc_valid, st.current_valid, _rt.source_age_ms(),
        st.lora_ok, st.lora_tx_count,
        _en.fresh if _en else False, st.espnow_rx_count,
    ))


def config_status():
    """Muestra si el Super Mini recibió y guardó los ajustes del T190."""
    if _settings is None:
        print("[config] todavía no inicializado")
        return
    print("[config] Super Mini: {}; revision={}; recorrido={:.1f}cm/pulso "
          "anti-rebote={}us; max={}km/h; factores gruesos={}".format(
        _supermini_feedback_status(), _settings.supermini_config_revision,
        _settings.supermini_meters_per_pulse * 100.0,
        _settings.supermini_debounce_us,
        _settings.supermini_max_speed_kmh,
        _settings.b_supermini_factors_milli))


def battery_status():
    """Lee VBAT ahora y muestra tension, ADC crudo y SOC por REPL."""
    global _battery_voltage, _battery_percent, _battery_error
    global _battery_adc_raw, _battery_adc_pin_voltage
    global _battery_adc_read_method
    try:
        sample = HW.read_system_battery_sample()
        _battery_voltage = sample["voltage_v"]
        _battery_percent = percent_from_voltage(_battery_voltage)
        _battery_adc_raw = sample["raw_median"]
        _battery_adc_pin_voltage = sample["pin_voltage_v"]
        _battery_adc_read_method = sample["read_method"]
        _battery_error = None
    except Exception as exc:
        _battery_voltage = None
        _battery_percent = None
        _battery_adc_raw = None
        _battery_adc_pin_voltage = None
        _battery_adc_read_method = None
        _battery_error = "{}".format(exc)
        print("[battery] error de lectura:", exc)
        return
    print("[battery] {:.3f} V, {}%, GPIO6={:.4f} V, ADC raw={}, metodo={}".format(
        _battery_voltage, _battery_percent, _battery_adc_pin_voltage,
        _battery_adc_raw, _battery_adc_read_method))


def log_start():
    """Solicita inicio manual del log; la escritura la hace la tarea asyncio."""
    global _LOG_MANUAL_OVERRIDE
    if _sd_logger is None or not _sd_logger.ready:
        detail = _sd_error if _sd_logger is None else _sd_logger.error
        print("[SD] no disponible:", detail or "sin tarjeta montada")
        return False
    _LOG_MANUAL_OVERRIDE = True
    print("[SD] inicio manual solicitado")
    return True


def log_stop():
    """Solicita detener el log sin escribir desde el hilo del REPL."""
    global _LOG_MANUAL_OVERRIDE
    if _sd_logger is None:
        print("[SD] logger no inicializado")
        return False
    _LOG_MANUAL_OVERRIDE = False
    print("[SD] detencion manual solicitada")
    return True


def log_auto():
    """Vuelve al modo automatico: iniciar al detectar movimiento."""
    global _LOG_MANUAL_OVERRIDE
    if _sd_logger is None or not _sd_logger.ready:
        detail = _sd_error if _sd_logger is None else _sd_logger.error
        print("[SD] no disponible:", detail or "sin tarjeta montada")
        return False
    _LOG_MANUAL_OVERRIDE = None
    print("[SD] modo automatico habilitado")
    return True


def log_status():
    """Muestra estado del montaje y archivo de registro."""
    if _sd_logger is None:
        print("[SD] no inicializado:", _sd_error or "sin bus compartido")
        return
    print("[SD] ready={} recording={} file={} mode={} error={}".format(
        _sd_logger.ready, _sd_logger.recording, _sd_logger.path,
        "auto" if _LOG_MANUAL_OVERRIDE is None else
        ("manual-on" if _LOG_MANUAL_OVERRIDE else "manual-off"),
        _sd_logger.error))


def deep_sleep():
    """Solicita deep sleep; S3/GPIO21 en nivel bajo es la fuente de despertar."""
    global _SLEEP_REQUESTED, _STOP_REQUESTED
    _SLEEP_REQUESTED = True
    if _RUNNING:
        _STOP_REQUESTED = True
        print("[sleep] solicitud aceptada; cerrando tareas antes de dormir")
        return True
    _enter_deep_sleep()
    return True


def gps_status():
    """Muestra por REPL el ultimo fix GPS y el waypoint de largada/llegada
    capturado, con el conteo de vueltas."""
    if _gps is None:
        print("[GPS] no inicializado")
        return
    fix = _gps.latest_fix()
    if fix is None:
        print("[GPS] sin fix reciente; satelites={} bytes_invalidos={} "
              "waypoint={} vueltas={}".format(
            _gps.satellites, _gps.invalid_bytes, _lap_waypoint, _lap_count))
        return
    print("[GPS] fix lat={:.6f} lon={:.6f} sats={} speed={:.1f}km/h "
          "bytes_invalidos={} waypoint={} vueltas={} ultima_vuelta={}".format(
        fix["latitude"], fix["longitude"], fix["satellites"],
        fix["speed_kmh"], _gps.invalid_bytes, _lap_waypoint, _lap_count,
        _format_mmss(_last_lap_time_s) if _last_lap_time_s is not None else "--"))


if AUTO_START:
    start()
