agusoa2008-sudo/lsf-ecoypf-performance/SUPER MINI S3/status_led.py

# status_led.py
# Indicador de estado por color + parpadeo sobre el NeoPixel onboard
# (GPIO48) del Super Mini -- unica señal visual del equipo sin display
# propio.
#
# No sabe nada de ADS1220/ADS1115/ESP-NOW en particular: solo recibe flags
# de salud (bool) y un flag de conexion, y decide color + patron. Brillo
# bajo a proposito (valores ~0-40) para no encandilar ni consumir de mas.
#
# Separa "cual es el estado" (update_health / set_espnow_connected, los
# llama sensor_task cada vez que lee) de "como se ve en el tiempo" (tick,
# lo llama una tarea aparte a ritmo fijo -- ver main.py: led_task). Asi el
# parpadeo no depende de cada cuanto se leen los sensores.
#
# Patron:
#   - rojo parpadeando  = algun sensor en falla (update_health con 0 OK)
#   - amarillo parpadeando = falla parcial (update_health con OK mixto)
#   - verde parpadeando = todo OK
#   - verde/azul alternando = todo OK + ESP-NOW conectado
#   - modo debug/status activo (ver main.py: set_debug_mode): el color de
#     salud de arriba se mantiene igual (sigue siendo la señal que importa,
#     incluso en modo debug), pero el hueco entre destellos deja de ser
#     apagado y pasa a magenta tenue -- se ve claramente de lejos que el
#     AP esta prendido sin tapar si hay un sensor fallando. Magenta y no
#     azul a proposito: azul ya significa "ESP-NOW conectado" en el patron
#     de arriba, usar el mismo color para dos cosas distintas confundiria.

_COLOR_BOOT    = (0, 0, 40)    # azul tenue -- arrancando / calibrando
_COLOR_OK      = (0, 40, 0)    # verde -- todos los subsistemas OK
_COLOR_PARTIAL = (40, 30, 0)   # amarillo -- falta alguno
_COLOR_FAIL    = (40, 0, 0)    # rojo -- ninguno OK / error critico
_COLOR_ESPNOW  = (0, 0, 40)    # azul -- se alterna con verde si hay link
_COLOR_DEBUG   = (25, 0, 25)   # magenta tenue -- modo debug/status activo
_COLOR_OFF     = (0, 0, 0)


class StatusLed:
    def __init__(self, neopixel):
        self._np = neopixel
        self._ok = None            # None=booteando, True, False, "partial"
        self._espnow_connected = False
        self._debug_mode = False
        self._on = False
        self.set_boot()

    def _set(self, color):
        self._np[0] = color
        self._np.write()

    def set_boot(self):
        self._ok = None
        self._set(_COLOR_BOOT)

    def off(self):
        """Apaga el LED -- llamar antes de machine.deepsleep() (ver
        main.py: _enter_deep_sleep). El NeoPixel retiene el ultimo color
        escrito aunque el CPU se duerma, asi que si no se apaga a mano
        queda prendido (drenando corriente) durante todo el sleep."""
        self._ok = None
        self._on = False
        self._set(_COLOR_OFF)

    def update_health(self, *health_flags):
        """health_flags: un bool por subsistema (ej. adc_ok, current_ok).
        Solo actualiza el estado interno -- tick() es el que pinta."""
        if not health_flags:
            self._ok = None
            return
        n_ok = sum(1 for f in health_flags if f)
        if n_ok == len(health_flags):
            self._ok = True
        elif n_ok == 0:
            self._ok = False
        else:
            self._ok = "partial"

    def set_espnow_connected(self, connected):
        """Llamar desde la tarea de ESP-NOW cuando cambie el estado del
        link (todavia no implementada -- queda listo para cuando este)."""
        self._espnow_connected = connected

    def set_debug_mode(self, active):
        """Llamar desde main.py (_toggle_debug_ap) cuando el modo
        debug/status entra o sale. No reemplaza el color de salud -- solo
        cambia que se muestra en el hueco entre destellos (ver tick)."""
        self._debug_mode = active

    def tick(self):
        """Llamar periodicamente (ver main.py: led_task, cada ~300ms) --
        alterna el LED segun el ultimo estado cargado por update_health()/
        set_espnow_connected()/set_debug_mode(). El color de salud
        (rojo/amarillo/verde/azul de arranque) manda siempre; lo unico que
        cambia segun debug_mode/espnow es el color del hueco entre
        destellos, en orden de prioridad: debug > ESP-NOW > apagado."""
        self._on = not self._on
        if self._debug_mode:
            gap_color = _COLOR_DEBUG
        elif self._espnow_connected and self._ok is True:
            gap_color = _COLOR_ESPNOW
        else:
            gap_color = _COLOR_OFF

        if self._ok is None:
            self._set(_COLOR_BOOT if self._on else gap_color)
        elif self._ok is False:
            self._set(_COLOR_FAIL if self._on else gap_color)
        elif self._ok == "partial":
            self._set(_COLOR_PARTIAL if self._on else gap_color)
        else:
            self._set(_COLOR_OK if self._on else gap_color)
