agusoa2008-sudo/lsf-ecoypf-performance/(commit log)

2026-10-26 Commit inicial: documentacion de arquitectura y firmware de Super Mini S3, T190 y Paddock S3
    Incluye la arquitectura del sistema de telemetria EcoYPF 2026, el estado
    funcional de cada nodo, y el firmware MicroPython de los tres dispositivos
    (sensado ESP-NOW, display/gateway LoRa y receptor/dashboard de paddock).
2026-10-26 Reenfocar documentacion en el objetivo de performance (Wh/km), no telemetria por si misma
    Renombra el proyecto a LSF EcoYPF - Performance y agrega, en ambos
    documentos de arquitectura y funcionalidades, el por que de cada sensor y
    calculo en funcion de la eficiencia energetica que define la categoria.
2026-10-26 Redefinir el dato central: potencia objetivo vs. potencia actual, no Wh/km
    La prueba de Endurance tiene tiempo fijo (80 min) y energia fija (bateria
    sellada): el numero accionable en vivo es la potencia que agota la bateria
    justo al final, comparada contra la potencia actual, no la eficiencia del
    auto en abstracto. El Wh/km pasa a ser un dato secundario de analisis
    post-tanda. Se documenta la justificacion fisica (arrastre aerodinamico,
    efecto Peukert en la bateria de plomo-acido) y se deja registrado como
    pendiente de implementacion: falta un reloj de carrera y el calculo de
    energia restante en el firmware.
2026-10-27 Implementar potencia objetivo, reloj de carrera, energia Peukert, navegacion y reset remoto
    Agrega las piezas que faltaban para el dato central del proyecto (potencia
    objetivo vs. potencia actual, ver docs/ARQUITECTURA_TELEMETRIA_ECOYPF.md Sec0):
    reloj de carrera de 80 min con persistencia (idle/running/paused/finished),
    energia restante con modelo Peukert parametrizable (neutro por defecto, a
    calibrar con datos reales, ver docs/CALIBRACION_PEUKERT.md), y el calculo de
    potencia objetivo en la nueva pantalla CARRERA (home).
    Reemplaza la vieja lista plana de pantallas por una tabla PAGES uniforme (12
    pantallas agrupadas) y agrega un mecanismo de combos de boton (buttons.py) para
    el nuevo mapa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
2026-10-28 Agregar broadcast ESP-NOW de telemetria para displays secundarios
    El Super Mini S3 ahora, ademas del unicast al T190, difunde el mismo
    frame TLM por broadcast ESP-NOW (sin pairing ni CFG/RST) para que
    displays secundarios de solo lectura puedan mostrarlo. El broadcast es
    best-effort y se manda siempre despues del unicast, sin condicionar a
    su resultado, para no retrasar ni afectar el envio critico al T190.
2026-10-30 Agregar esquematico KiCad del Super Mini y fotos/videos de armado
    Incorpora el proyecto KiCad de cableado del Super Mini S3 (esquematico,
    PCB, simbolos) en docs/KiCad/, ignorando el historial local del editor
    (.history/, repo git anidado) y los lock files (*.lck), que no aportan
    nada versionados.
    Suma tambien fotos y videos del armado fisico del auto y de los
    componentes de electronica en docs/Fotos/, como referencia visual que
    complementa la documentacion de arquitectura.
2026-10-30 Sumar historia del desarrollo con fotos al README y corregir estado de potencia objetivo
    Agrega una seccion "Historia del desarrollo" al final del README con dos fotos
    del armado (carroceria y electronica de a bordo), enlazando a docs/Fotos/ y
    docs/KiCad/ para el resto del material. De paso corrige la introduccion, que
    todavia decia que la potencia objetivo no estaba implementada.
2026-10-30 Sumar boceto y captura del esquematico a la historia del desarrollo
    Completa la seccion del README con las dos capturas que faltaban: el boceto
    a mano del cableado del Super Mini y el esquematico ya pasado a KiCad --
    muestran el camino de diseno completo junto a las fotos de armado fisico.
2026-11-06 Diagnosticar y arreglar crash de ESP-NOW/uasyncio en Super Mini y T190
    Causa raiz de las perdidas intermitentes de ESP-NOW: ambos main.py corrian
    asyncio.run() dentro de un _thread de fondo ("REPL libre"), lo que
    corrompe el estado global de uasyncio (MicroPython issue #8340, sin fix
    upstream) y crasheaba cualquiera de las dos placas al azar, cortando
    ESP-NOW varios segundos en cada reboot. Se sacó ese patron en ambas
    (Super Mini y T190/New T190+T190 Last) -- ver diagnostico espnow/
    DIAGNOSTICO.md para la evidencia completa (logs, crash dumps, analisis).
    De paso, en T190: LoRa cooperativo (no bloquea el resto mientras
    transmite), GPS acepta hora sin fix completo con filtro de fecha ancla,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
2026-11-06 Eliminar New T190/ (duplicado exacto de T190 Last/)
    No tenia sentido mantener dos copias identicas del firmware T190 en
    paralelo -- T190 Last/ queda como la unica carpeta de referencia para
    el T190 de ahora en mas.
